mlab-upenn/Remote-Autonomous-Vehicle-Explorer-Network/images/photos/PartsArrivedNov1/CHRimu.JPG

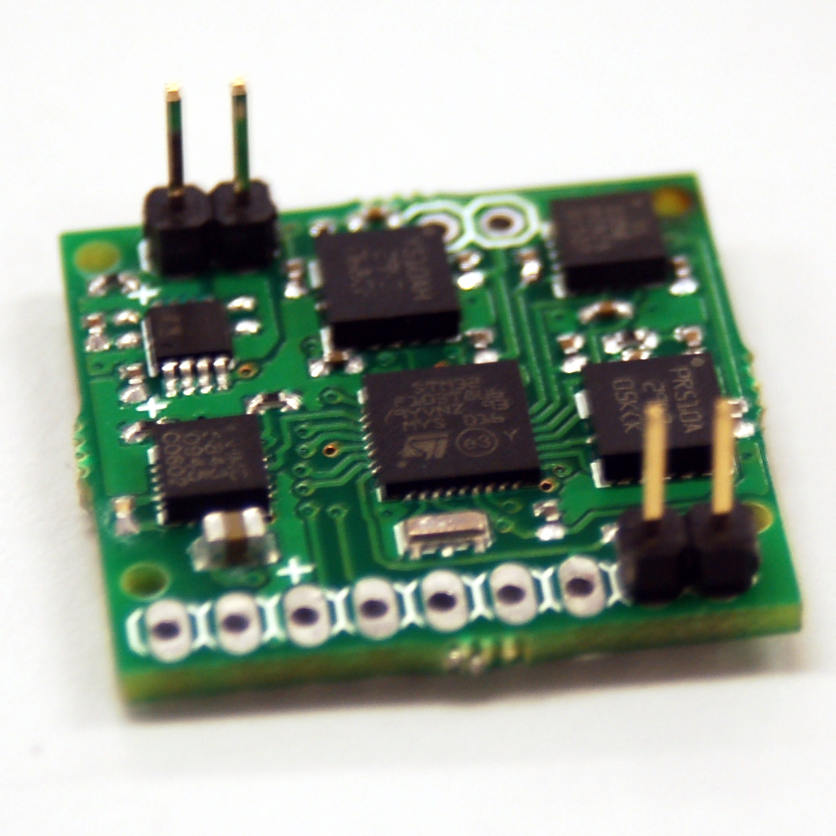
images/photos/PartsArrivedNov1/CHRimu.JPG
