mlab-upenn/Remote-Autonomous-Vehicle-Explorer-Network/images/photos/PartsArrivedNov1/exceedReceiver.JPG

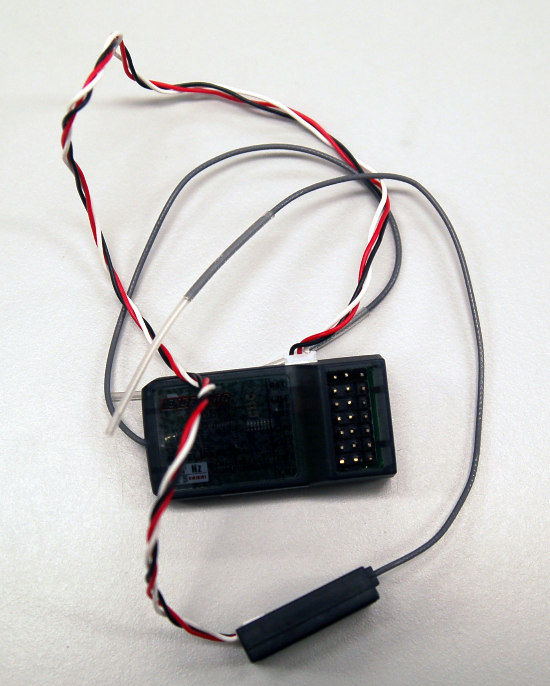
images/photos/PartsArrivedNov1/exceedReceiver.JPG
