mlab-upenn/Remote-Autonomous-Vehicle-Explorer-Network/codebase/ESC Firmware/17a410_ppm_r06/fuses_17a.jpg

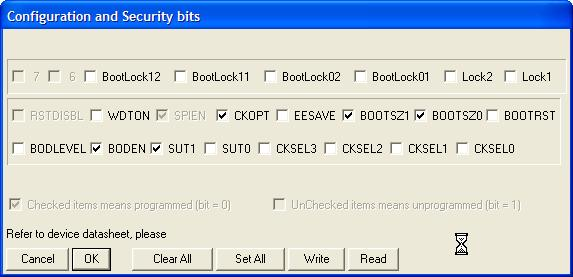
codebase/ESC Firmware/17a410_ppm_r06/fuses_17a.jpg
