mlab-upenn/Remote-Autonomous-Vehicle-Explorer-Network/codebase/ESC Firmware/TGYP2010_416HzRCIntervalRate_PPM-Mod-only_NoCal/CoRRECT FUSE SETTINGS.png

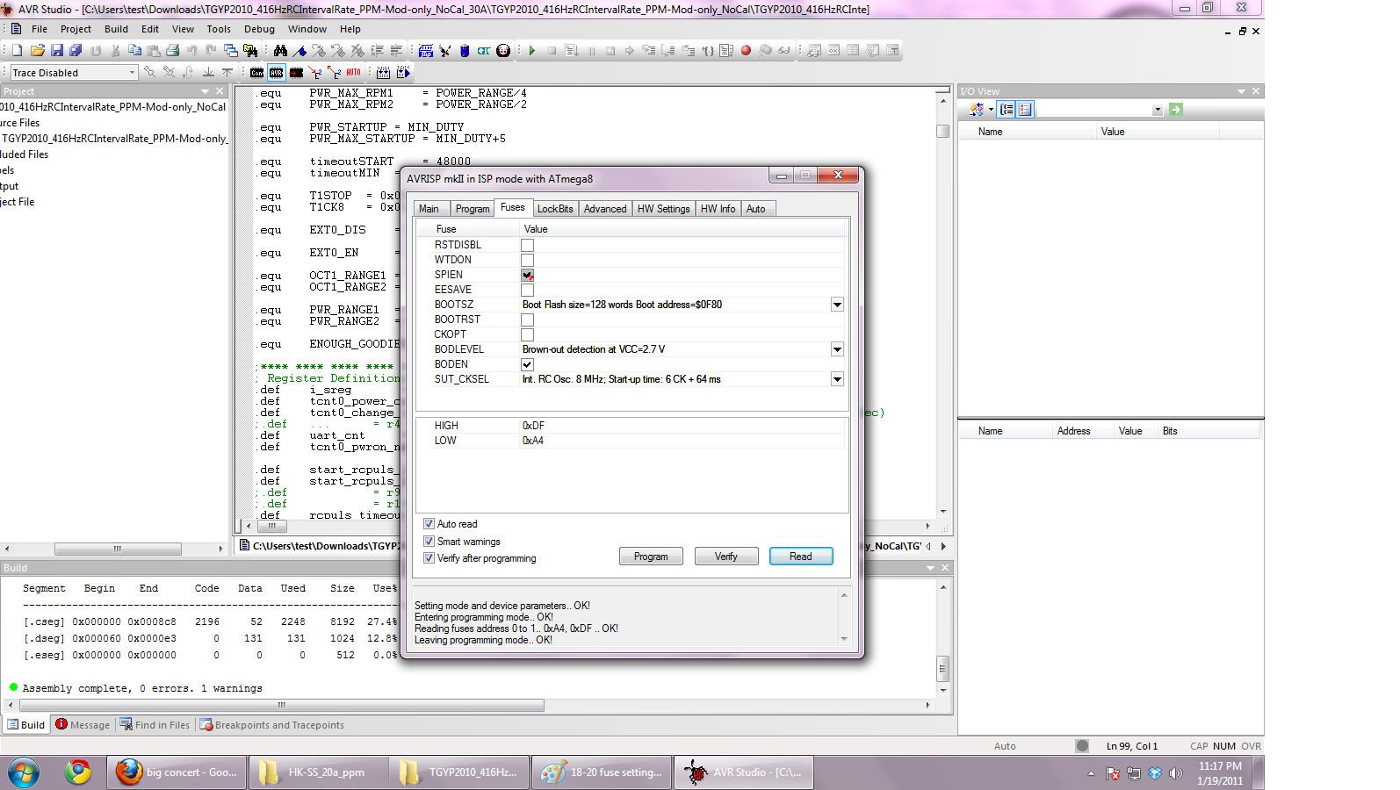
codebase/ESC Firmware/TGYP2010_416HzRCIntervalRate_PPM-Mod-only_NoCal/CoRRECT FUSE SETTINGS.png
