mlab-upenn/Remote-Autonomous-Vehicle-Explorer-Network/codebase/ESC Firmware/Working with HK SS 25-30A CP/Fuse Settings.png

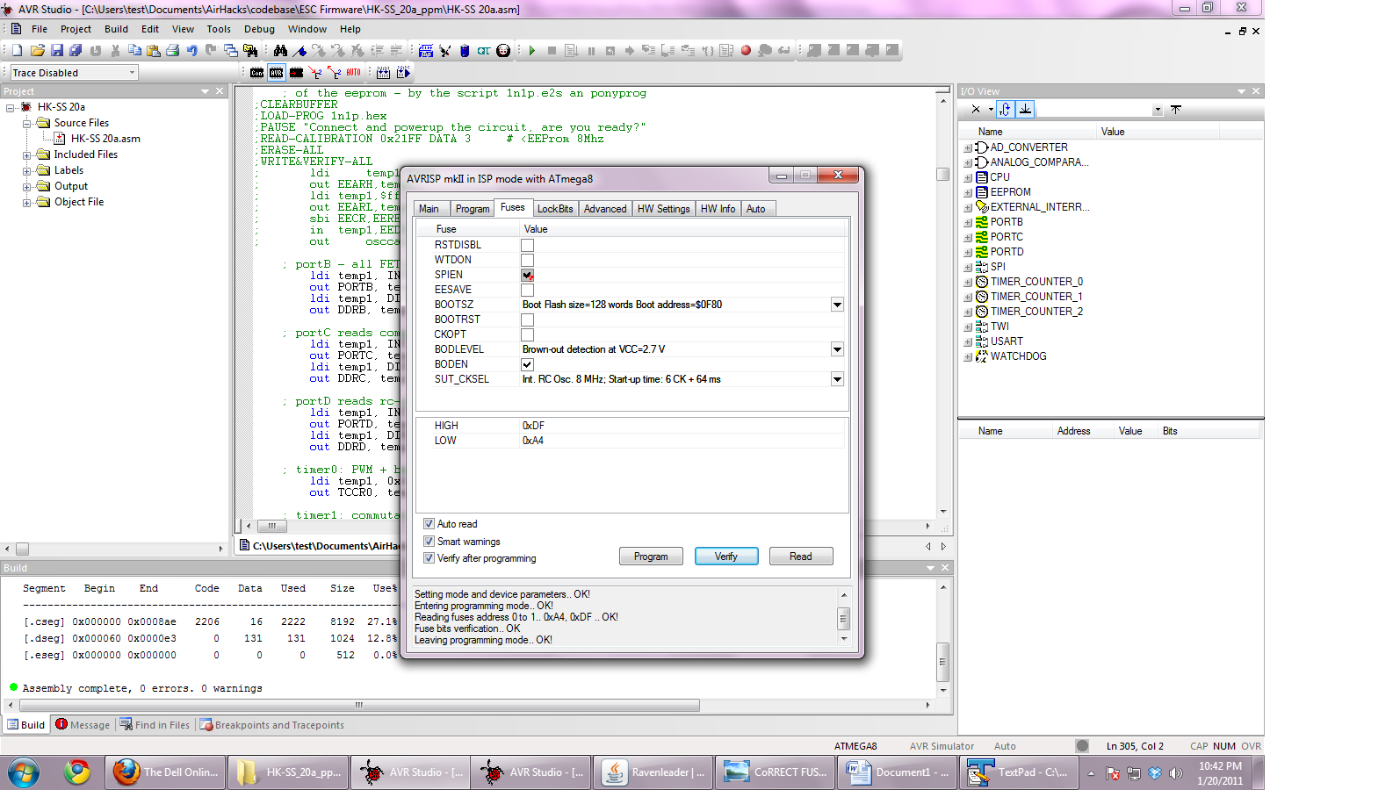
codebase/ESC Firmware/Working with HK SS 25-30A CP/Fuse Settings.png
