mlab-upenn/Remote-Autonomous-Vehicle-Explorer-Network/images/graphics/guiStart.png

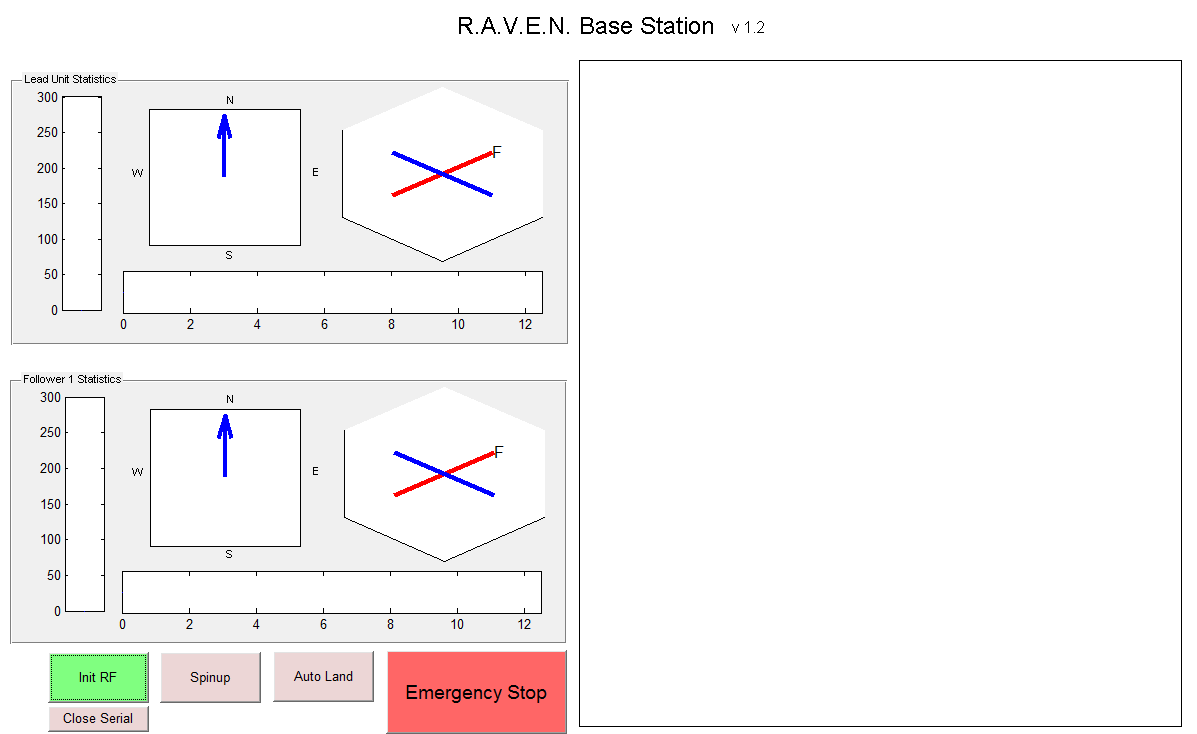
images/graphics/guiStart.png
