mlab-upenn/Remote-Autonomous-Vehicle-Explorer-Network/images/graphics/modelCamera.jpg

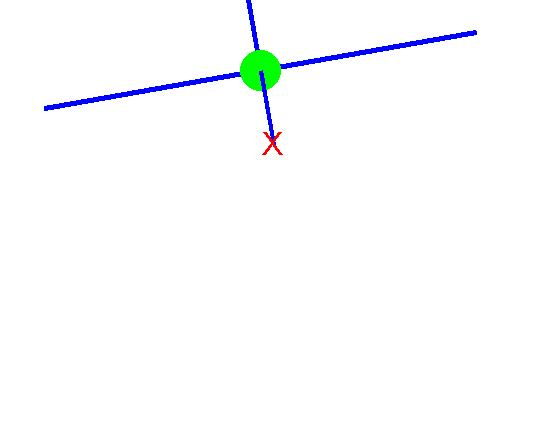
images/graphics/modelCamera.jpg
