mlab-upenn/Remote-Autonomous-Vehicle-Explorer-Network/images/graphics/modelPerspective.jpg

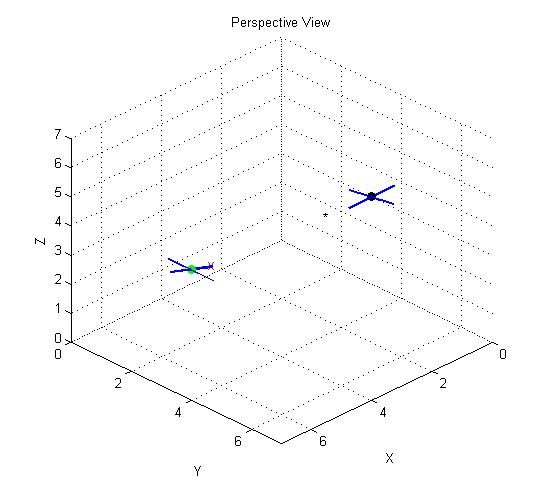
images/graphics/modelPerspective.jpg
