mlab-upenn/Remote-Autonomous-Vehicle-Explorer-Network/images/graphics/thrust1045.png

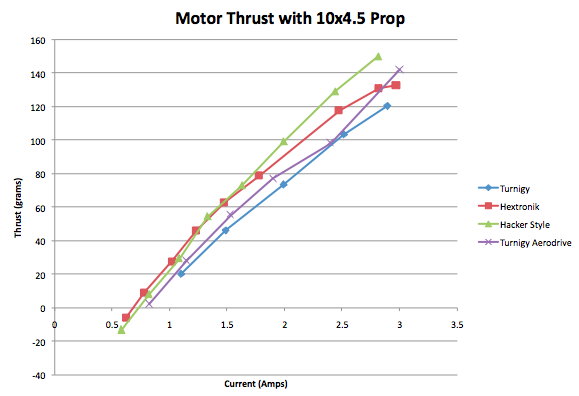
images/graphics/thrust1045.png
