mlab-upenn/Remote-Autonomous-Vehicle-Explorer-Network/images/photos/ESC/fuses.PNG

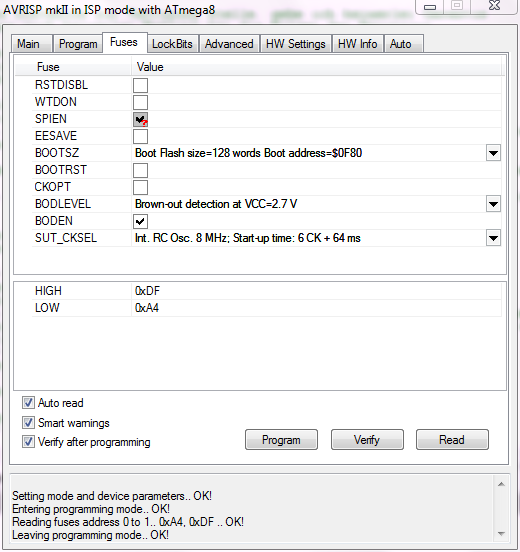
images/photos/ESC/fuses.PNG
