mlab-upenn/Remote-Autonomous-Vehicle-Explorer-Network/images/photos/GyroNoise/gyroNoiseFilter.png

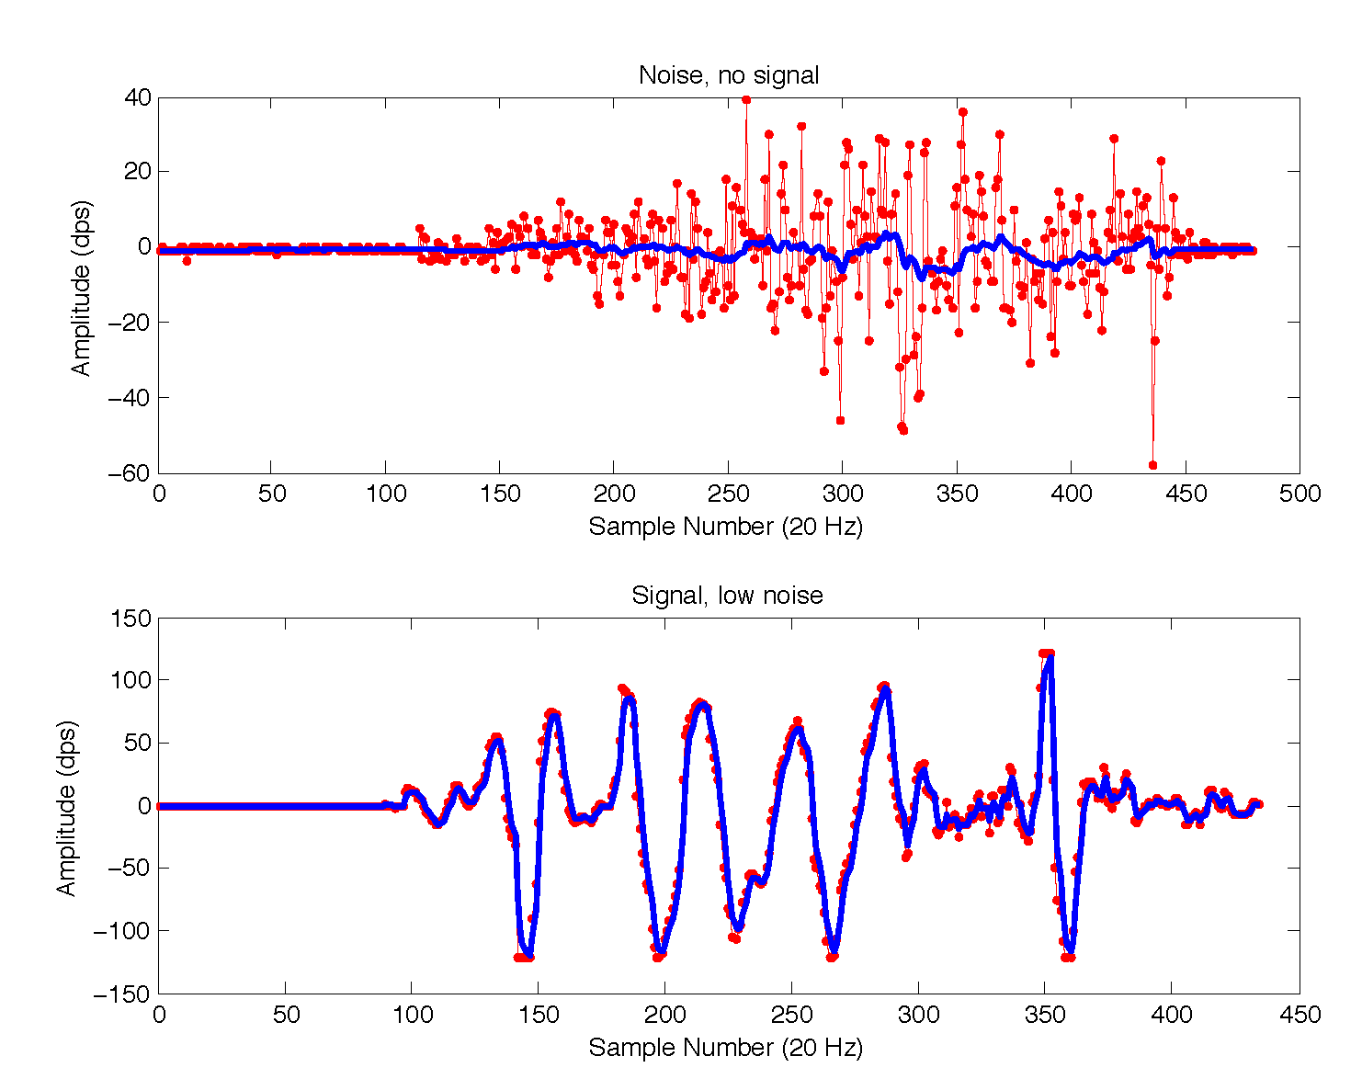
images/photos/GyroNoise/gyroNoiseFilter.png
