mlab-upenn/Remote-Autonomous-Vehicle-Explorer-Network/images/rateGyroScreenShots/angles props spinning/Screen shot 2011-03-27 at 12.30.48 AM.png

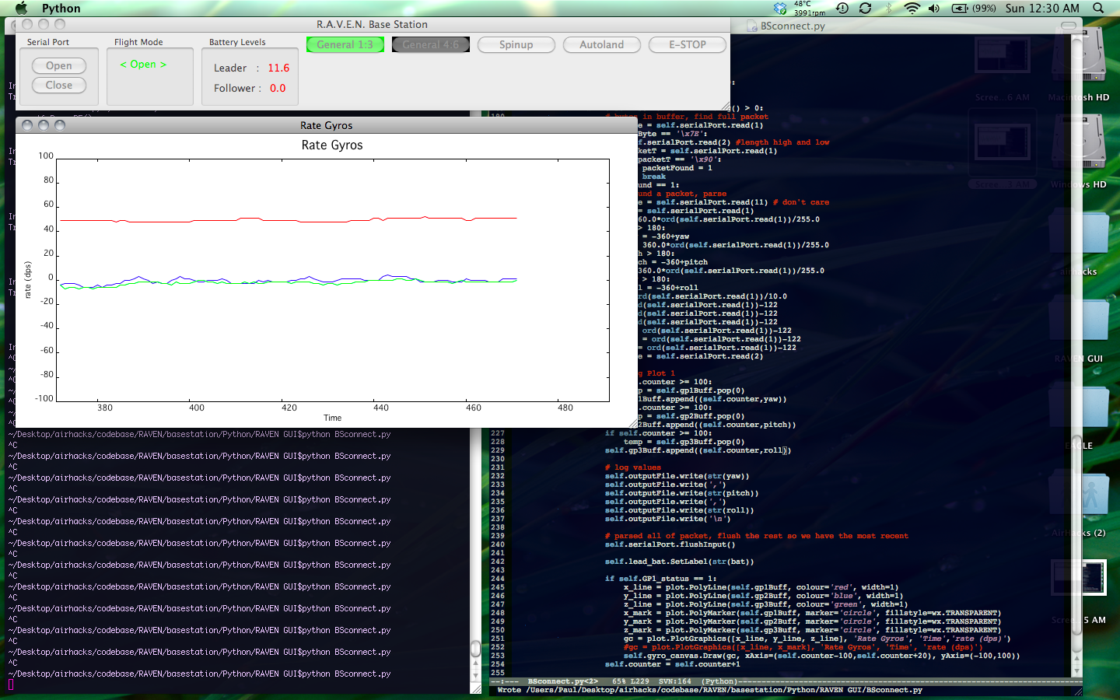
images/rateGyroScreenShots/angles props spinning/Screen shot 2011-03-27 at 12.30.48 AM.png
