mlab-upenn/Remote-Autonomous-Vehicle-Explorer-Network/images/rateGyroScreenShots/first round - light lambs wool and foam/Screen shot 2011-03-26 at 3.06.36 PM.png

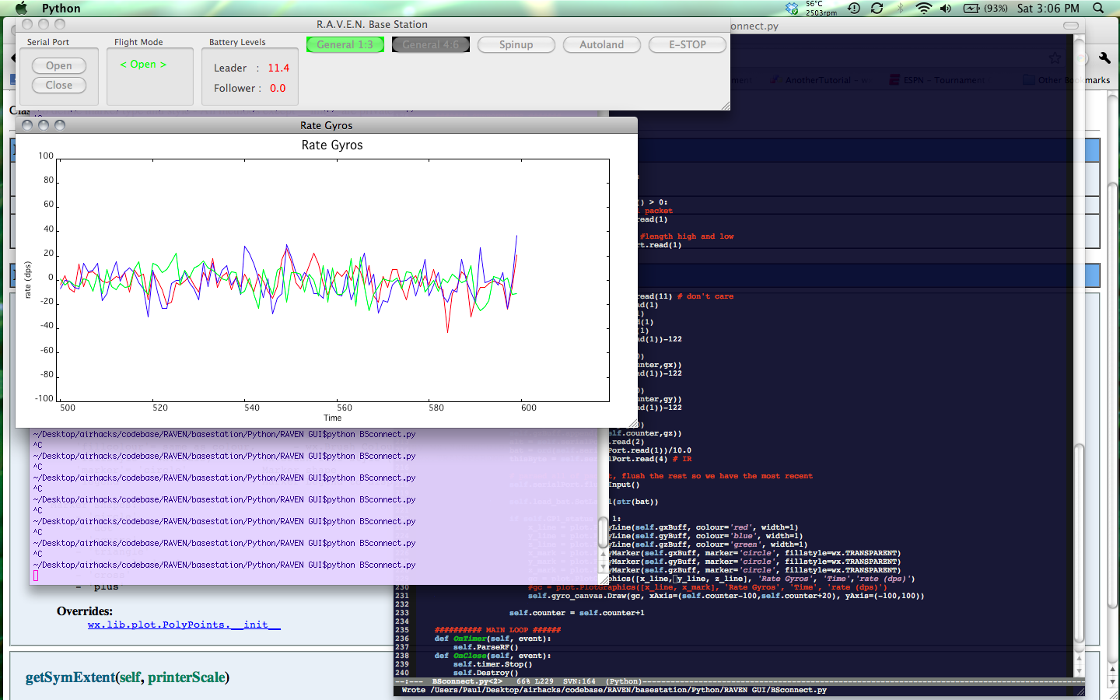
images/rateGyroScreenShots/first round - light lambs wool and foam/Screen shot 2011-03-26 at 3.06.36 PM.png
