mlab-upenn/Remote-Autonomous-Vehicle-Explorer-Network/images/rateGyroScreenShots/hardAttachedIMU/Screen shot 2011-03-26 at 11.12.29 PM.png

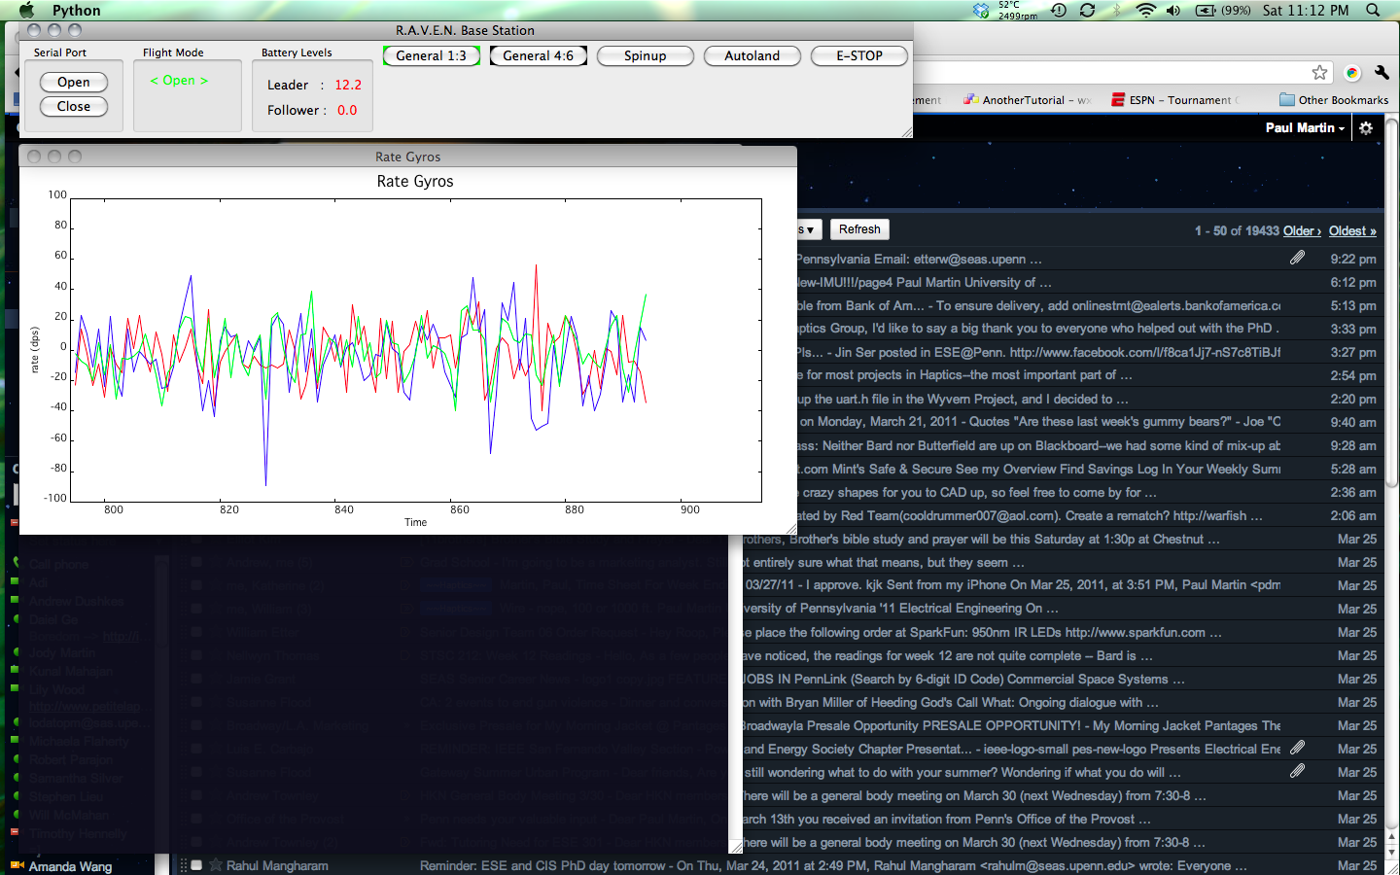
images/rateGyroScreenShots/hardAttachedIMU/Screen shot 2011-03-26 at 11.12.29 PM.png
