mlab-upenn/Remote-Autonomous-Vehicle-Explorer-Network/images/rateGyroScreenShots/in air/Screen shot 2011-03-26 at 3.31.38 PM.png

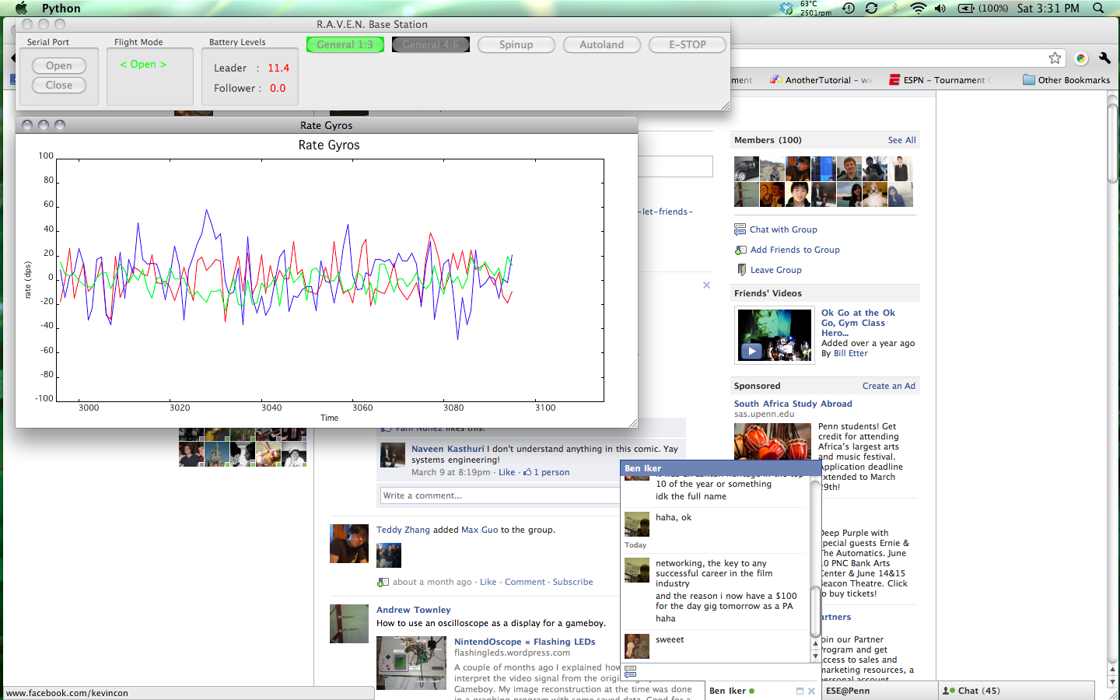
images/rateGyroScreenShots/in air/Screen shot 2011-03-26 at 3.31.38 PM.png
