mlab-upenn/Remote-Autonomous-Vehicle-Explorer-Network/images/rateGyroScreenShots/second round-only foam/Screen shot 2011-03-26 at 3.20.28 PM.png

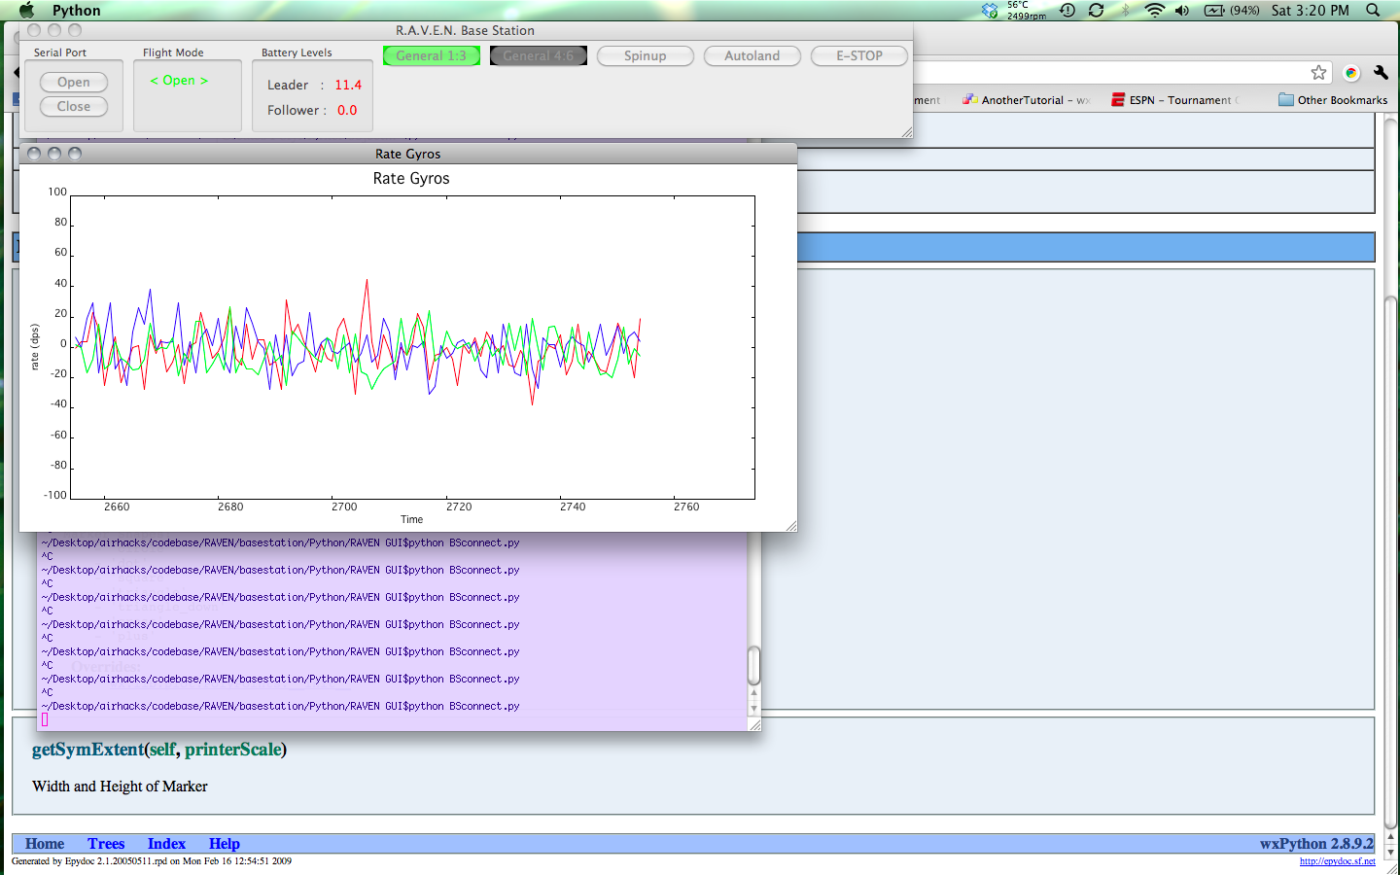
images/rateGyroScreenShots/second round-only foam/Screen shot 2011-03-26 at 3.20.28 PM.png
