mlab-upenn/Remote-Autonomous-Vehicle-Explorer-Network/images/rateGyroScreenShots/try2 only lambs wool/Screen shot 2011-03-26 at 3.26.39 PM.png

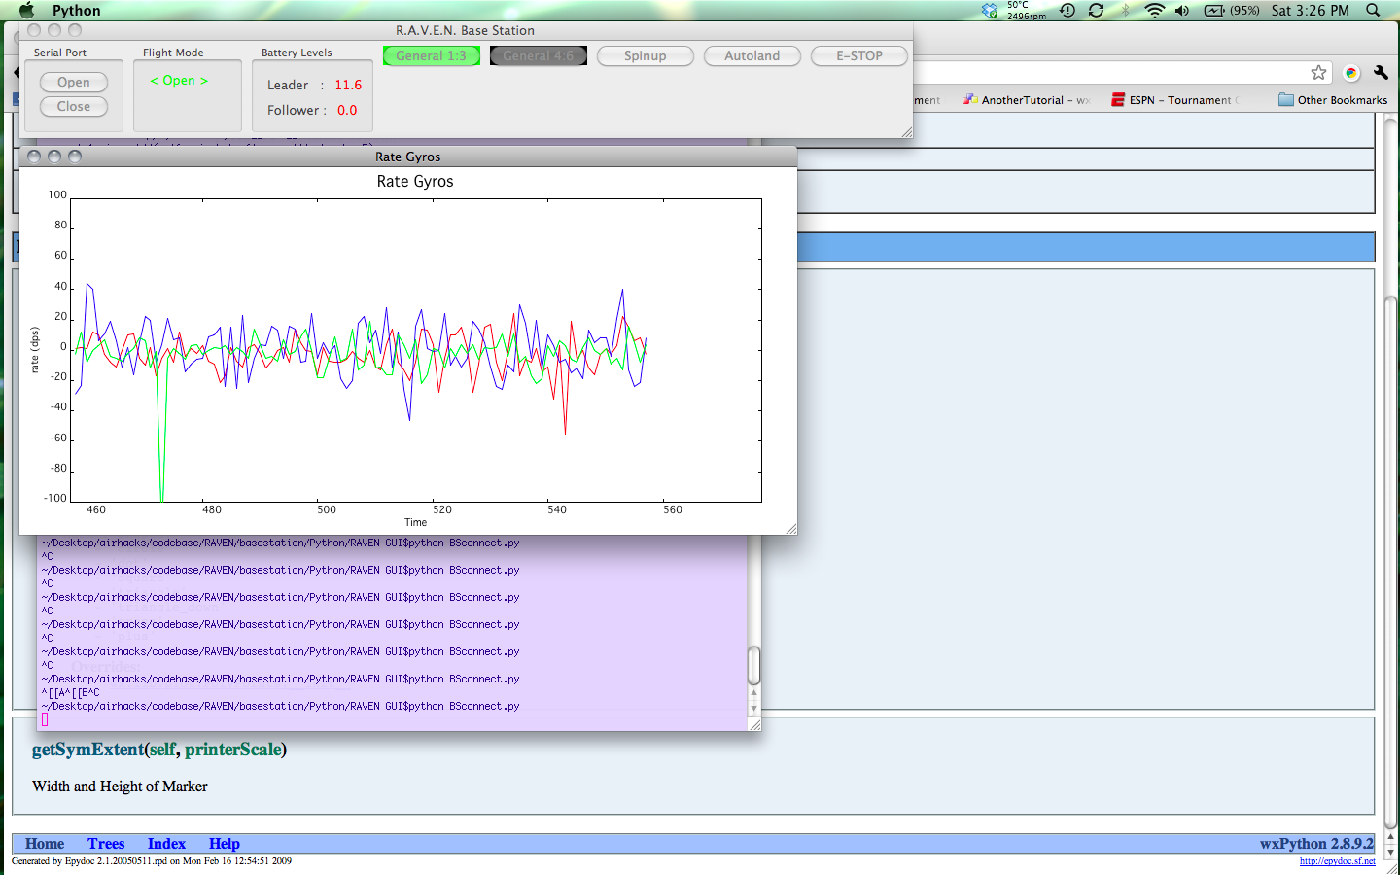
images/rateGyroScreenShots/try2 only lambs wool/Screen shot 2011-03-26 at 3.26.39 PM.png
