mlab-upenn/Remote-Autonomous-Vehicle-Explorer-Network/models/matlab/figures/deltaXpid.png

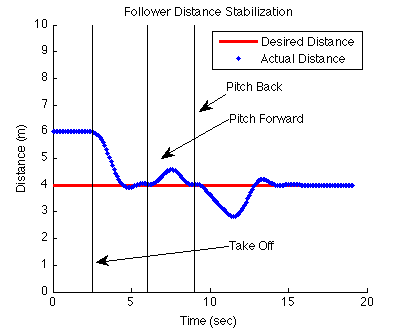
models/matlab/figures/deltaXpid.png
