mlab-upenn/Remote-Autonomous-Vehicle-Explorer-Network/models/matlab/figures/pitchPID.png

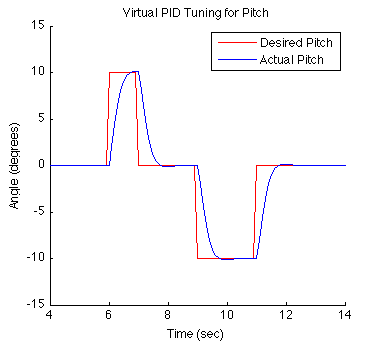
models/matlab/figures/pitchPID.png
