mlab-upenn/Remote-Autonomous-Vehicle-Explorer-Network/images/photos/PartsArrivedNov1/APM.JPG

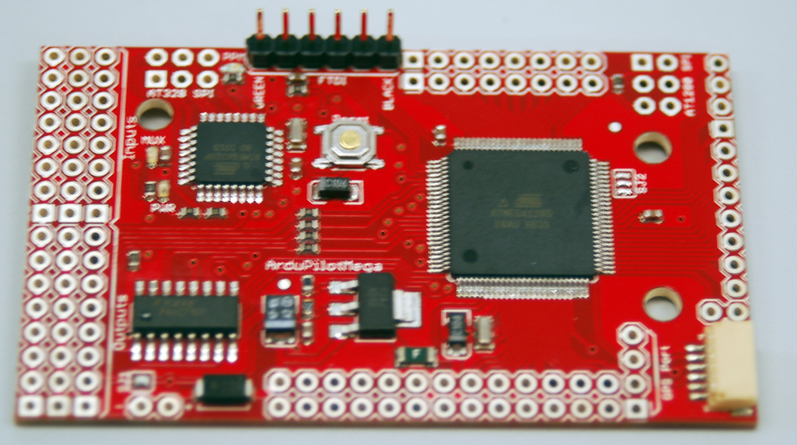
images/photos/PartsArrivedNov1/APM.JPG
