mlab-upenn/Remote-Autonomous-Vehicle-Explorer-Network/images/photos/PartsArrivedNov1/exceedRC.JPG

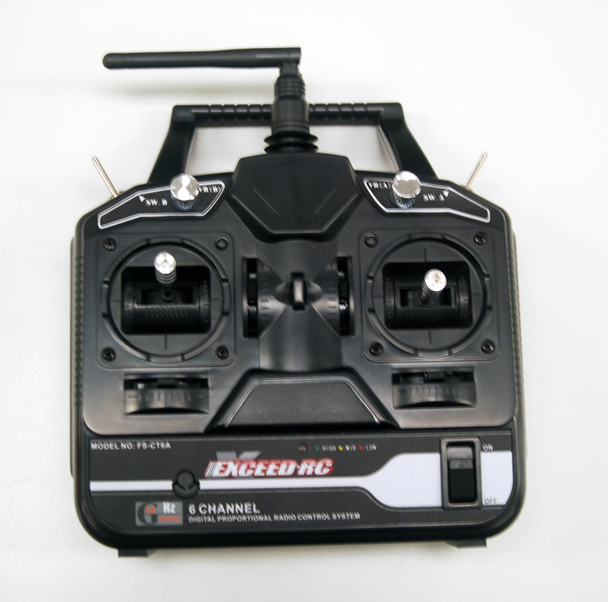
images/photos/PartsArrivedNov1/exceedRC.JPG
