mlab-upenn/Remote-Autonomous-Vehicle-Explorer-Network/images/photos/PartsArrivedNov1/frame.JPG

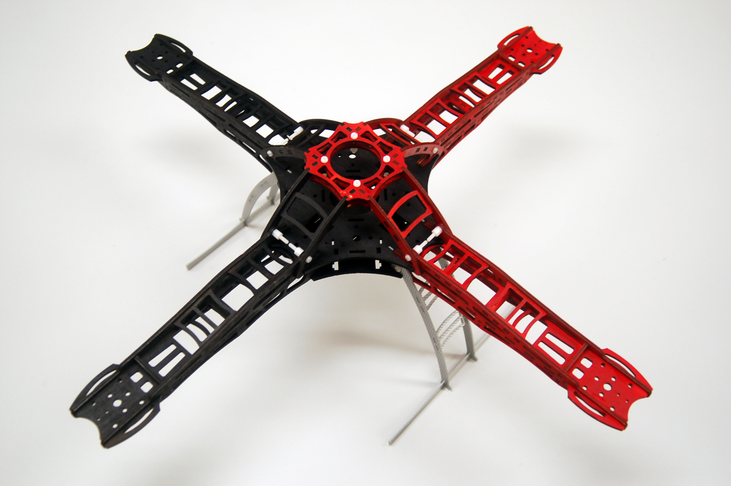
images/photos/PartsArrivedNov1/frame.JPG
