mlab-upenn/Remote-Autonomous-Vehicle-Explorer-Network/images/photos/PartsArrivedNov1/xbeeDuck.JPG

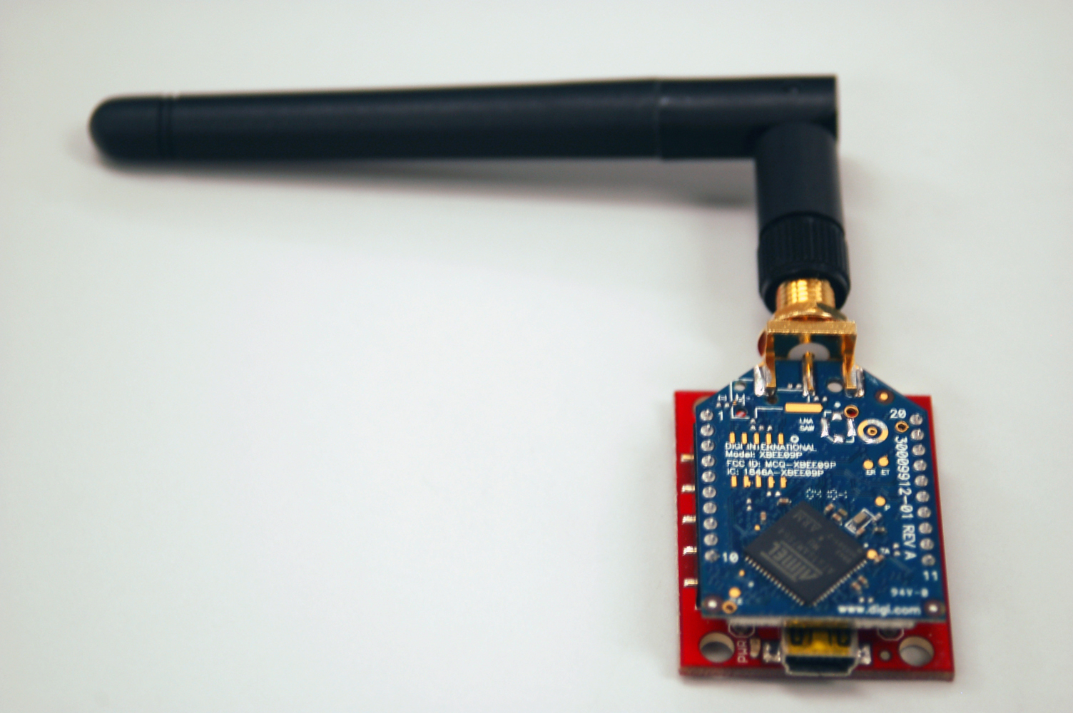
images/photos/PartsArrivedNov1/xbeeDuck.JPG
