mlab-upenn/Remote-Autonomous-Vehicle-Explorer-Network/images/photos/PartsArrivedNov1/xbeeWire.JPG

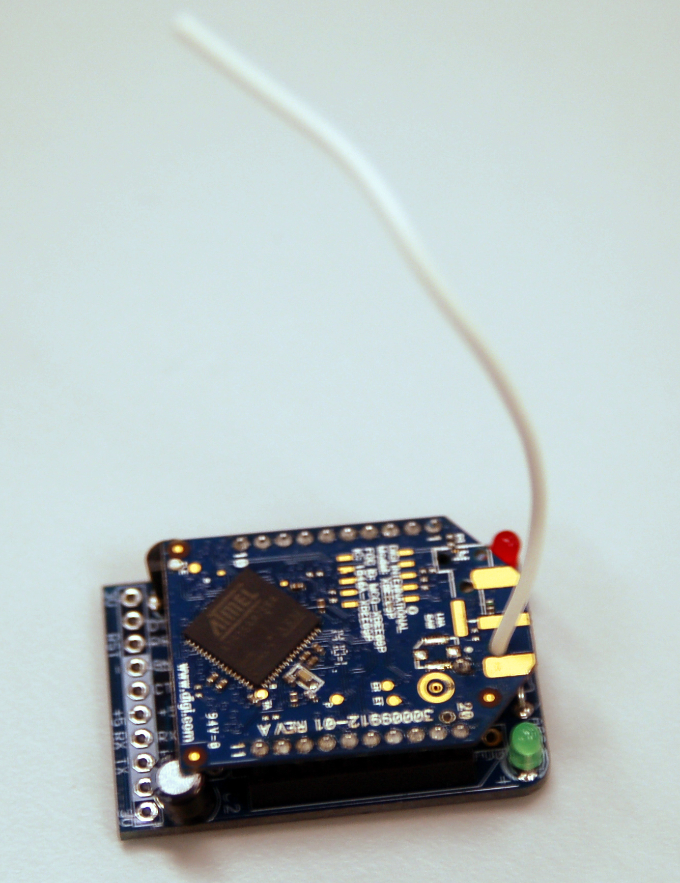
images/photos/PartsArrivedNov1/xbeeWire.JPG
