mlab-upenn/Remote-Autonomous-Vehicle-Explorer-Network/models/solidworks/Wyvern/Wyvern/FullAssembly.SLDASM

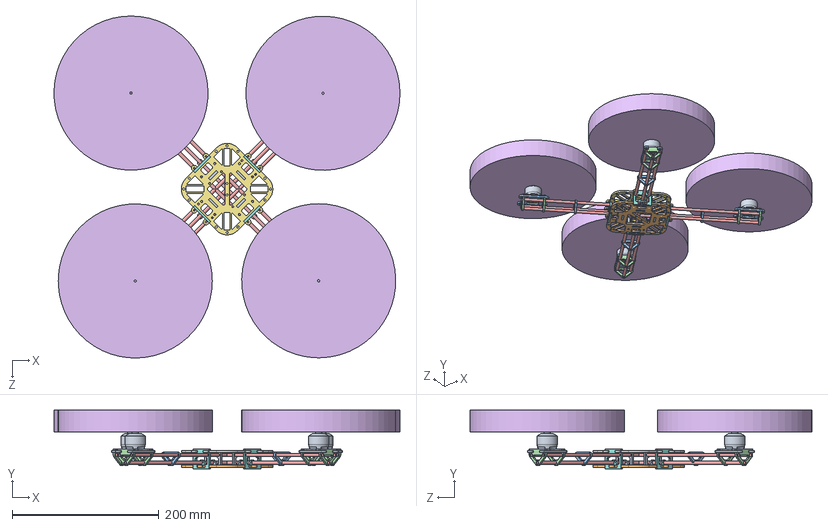
[picture p61: CAD file, 2012-02-28]
models/solidworks/Wyvern/Wyvern/FullAssembly.SLDASM
471.6 x 80.3 x 466.0 mm
a2208-14 x 4
MotorMount x 4
MotorNodeBase x 4
MotorNodeSide x 8
aluminumRod x 6
rotorest x 4
CenterNodeBaseTop
CenterNodeSide x 4
CenterNodeSideInner x 4
CenterNodeBaseBottom
SupportSide x 4
