mlab-upenn/Remote-Autonomous-Vehicle-Explorer-Network/models/solidworks/Wyvern/Wyvern/Motor/MotorAssem.SLDASM

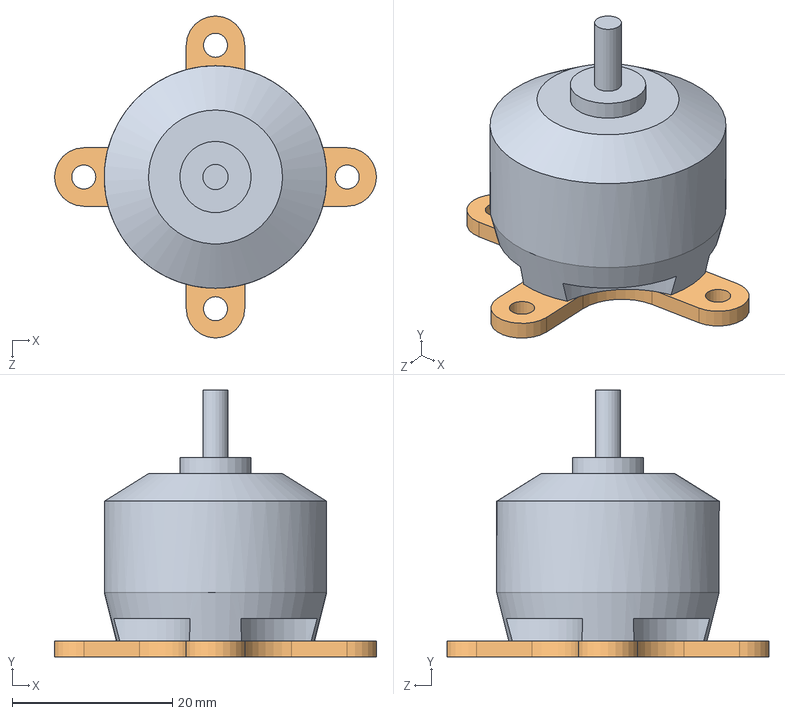
[picture p62: CAD file, 2012-02-28]
models/solidworks/Wyvern/Wyvern/Motor/MotorAssem.SLDASM
40.2 x 33.2 x 40.1 mm
a2208-14
MotorMount
