mlab-upenn/Remote-Autonomous-Vehicle-Explorer-Network/models/solidworks/Wyvern/Wyvern/MotorNode/MotorNodeAssem.SLDASM

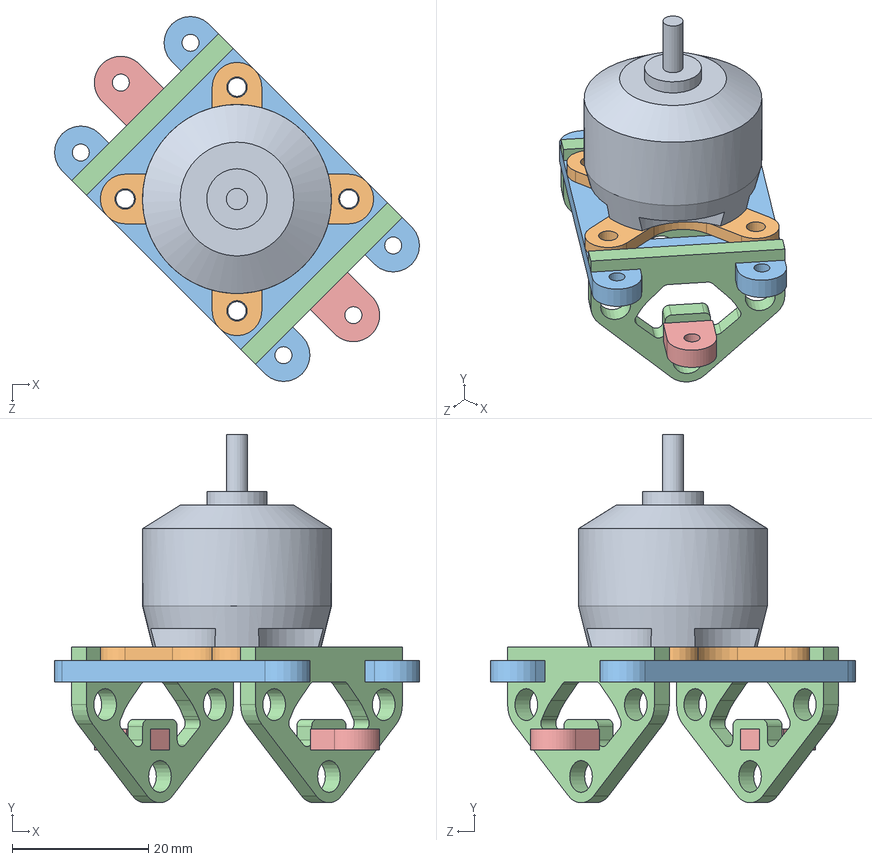
[picture p63: CAD file, 2012-02-28]
models/solidworks/Wyvern/Wyvern/MotorNode/MotorNodeAssem.SLDASM
53.6 x 54.1 x 53.6 mm
a2208-14
MotorMount
MotorNodeBase
MotorNodeSide x 2
ScrewNub x 2
