mlab-upenn/Remote-Autonomous-Vehicle-Explorer-Network/models/solidworks/Wyvern/Wyvern/NodeAssem.SLDASM

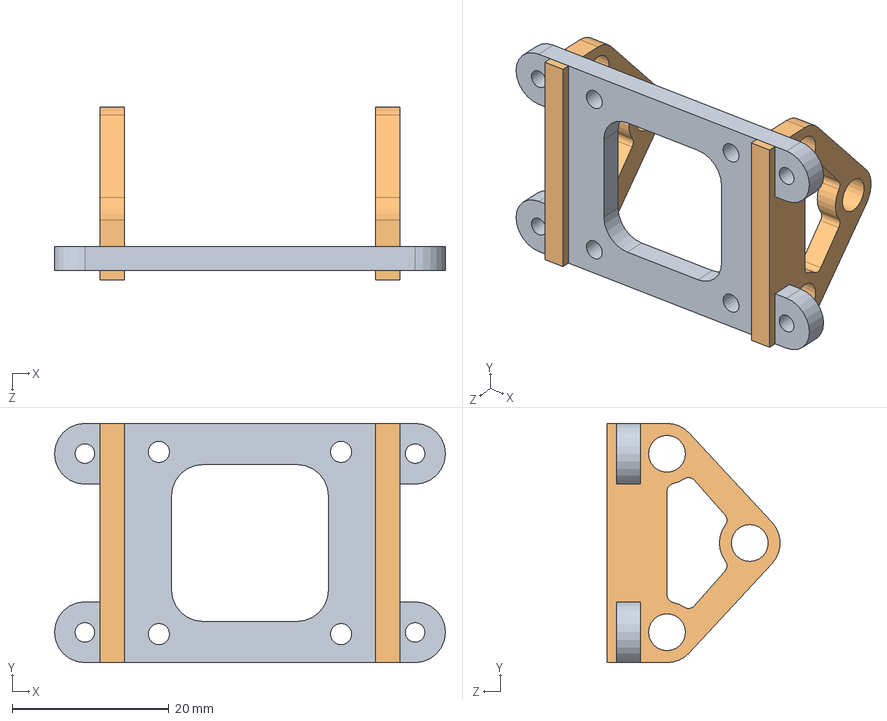
[picture p64: CAD file, 2012-02-28]
models/solidworks/Wyvern/Wyvern/NodeAssem.SLDASM
49.8 x 30.5 x 22.1 mm
MotorNodeBase
MotorNodeSide x 2
