mlab-upenn/Remote-Autonomous-Vehicle-Explorer-Network/models/solidworks/Wyvern/Wyvern/CenterNode/CenterNodeAssem.SLDASM

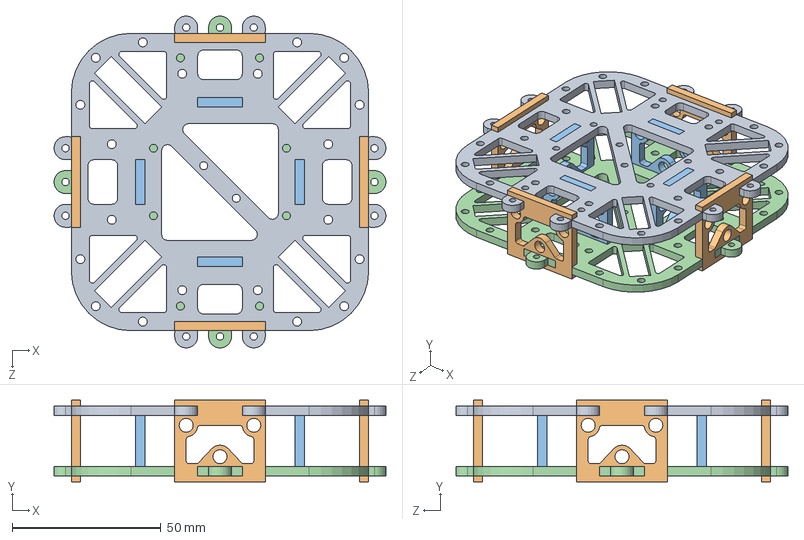
[picture p65: CAD file, 2012-02-28]
models/solidworks/Wyvern/Wyvern/CenterNode/CenterNodeAssem.SLDASM
111.7 x 27.5 x 111.7 mm
CenterNodeBaseTop
CenterNodeSide x 4
CenterNodeSideInner x 4
CenterNodeBaseBottom
