mlab-upenn/Remote-Autonomous-Vehicle-Explorer-Network/models/solidworks/Wyvern/Wyvern/HalfAssembly.SLDASM

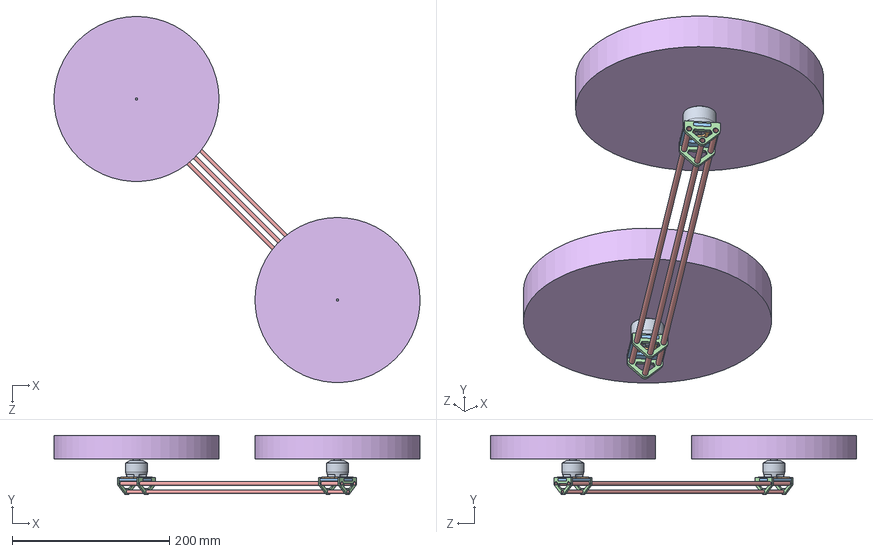
[picture p66: CAD file, 2012-02-28]
models/solidworks/Wyvern/Wyvern/HalfAssembly.SLDASM
465.7 x 75.7 x 465.8 mm
a2208-14 x 2
MotorMount x 2
MotorNodeBase x 2
MotorNodeSide x 4
aluminumRod x 3
rotorest x 2
