mlab-upenn/Remote-Autonomous-Vehicle-Explorer-Network/models/solidworks/Wyvern/Wyvern/Boards/Razor.SLDPRT

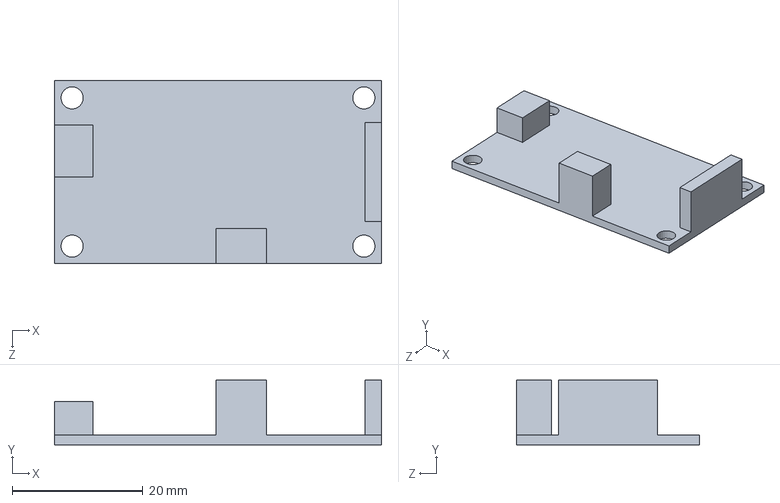
[picture p67: CAD file, 2012-02-28]
models/solidworks/Wyvern/Wyvern/Boards/Razor.SLDPRT
50.1 x 9.94 x 28.1 mm
