mlab-upenn/Remote-Autonomous-Vehicle-Explorer-Network/models/solidworks/Wyvern/Wyvern/CenterNode/CenterNodeBaseBottom.SLDPRT

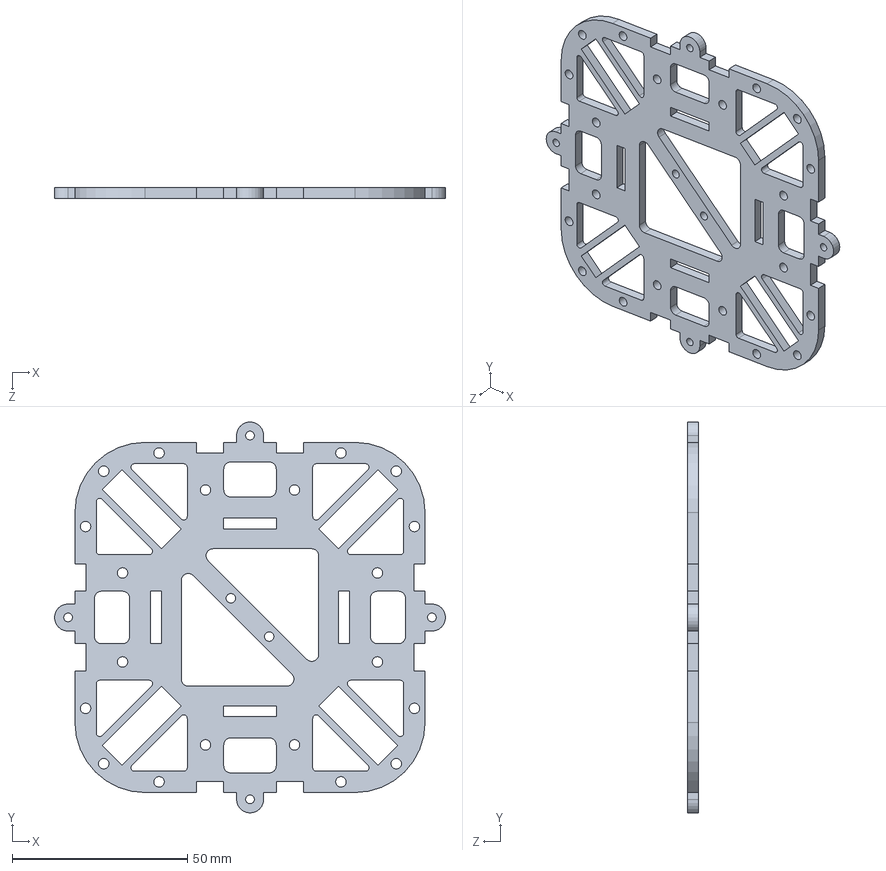
[picture p68: CAD file, 2012-02-28]
models/solidworks/Wyvern/Wyvern/CenterNode/CenterNodeBaseBottom.SLDPRT
111.7 x 111.6 x 3.10 mm
