mlab-upenn/Remote-Autonomous-Vehicle-Explorer-Network/models/solidworks/Wyvern/Wyvern/Motor/ESC.SLDPRT

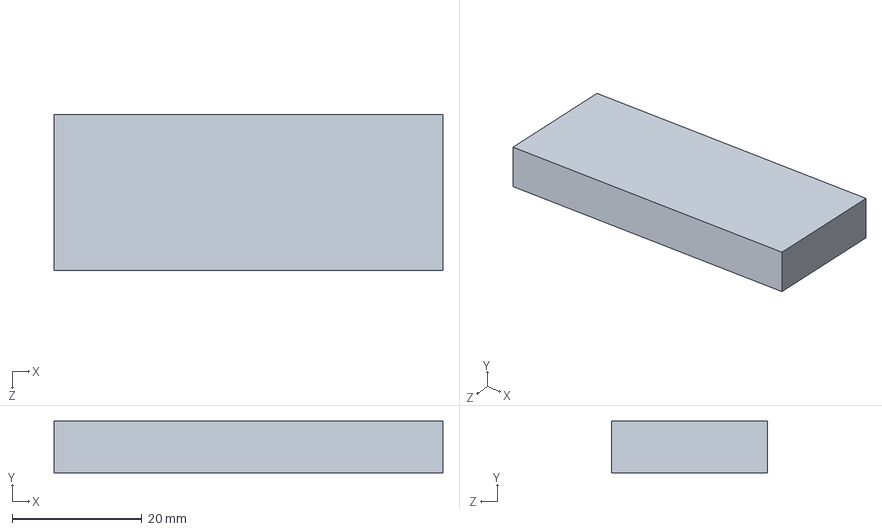
[picture p69: CAD file, 2012-02-28]
models/solidworks/Wyvern/Wyvern/Motor/ESC.SLDPRT
60.0 x 8.00 x 24.0 mm
