mlab-upenn/Remote-Autonomous-Vehicle-Explorer-Network/models/solidworks/Wyvern/Wyvern/MotorNode/MotorNodeBase.SLDPRT

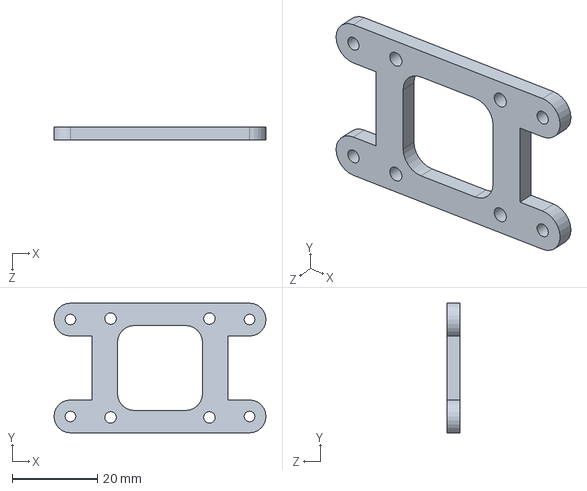
[picture p70: CAD file, 2012-02-28]
models/solidworks/Wyvern/Wyvern/MotorNode/MotorNodeBase.SLDPRT
49.8 x 30.5 x 3.10 mm
