mlab-upenn/Remote-Autonomous-Vehicle-Explorer-Network/models/solidworks/Wyvern/Wyvern/Boards/MAEVARM.SLDPRT

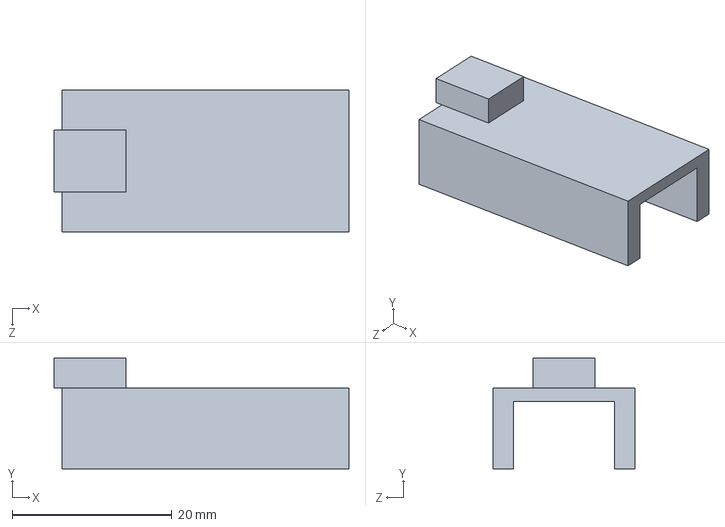
[picture p71: CAD file, 2012-02-28]
models/solidworks/Wyvern/Wyvern/Boards/MAEVARM.SLDPRT
36.9 x 13.8 x 17.8 mm
