mlab-upenn/Remote-Autonomous-Vehicle-Explorer-Network/models/solidworks/Wyvern/Wyvern/Motor/blueLipoBattery.SLDPRT

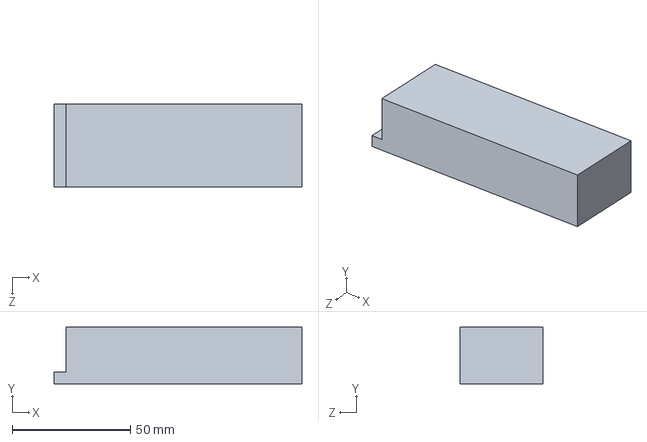
[picture p72: CAD file, 2012-02-28]
models/solidworks/Wyvern/Wyvern/Motor/blueLipoBattery.SLDPRT
105.0 x 24.0 x 35.0 mm
