mlab-upenn/Remote-Autonomous-Vehicle-Explorer-Network/models/solidworks/Wyvern/Wyvern/MotorNode/MotorNodeSide.SLDPRT

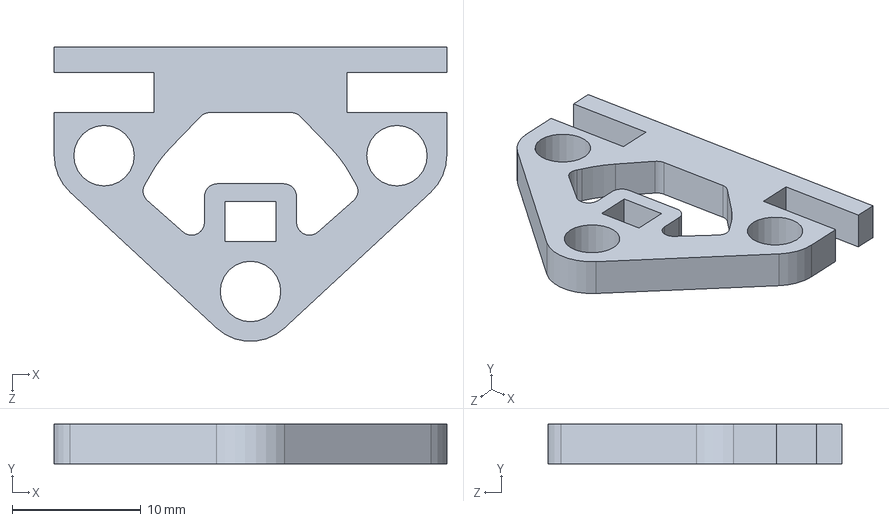
[picture p73: CAD file, 2012-02-28]
models/solidworks/Wyvern/Wyvern/MotorNode/MotorNodeSide.SLDPRT
30.5 x 3.10 x 22.9 mm
