mlab-upenn/Remote-Autonomous-Vehicle-Explorer-Network/models/solidworks/Wyvern/Wyvern/rotorest.SLDPRT

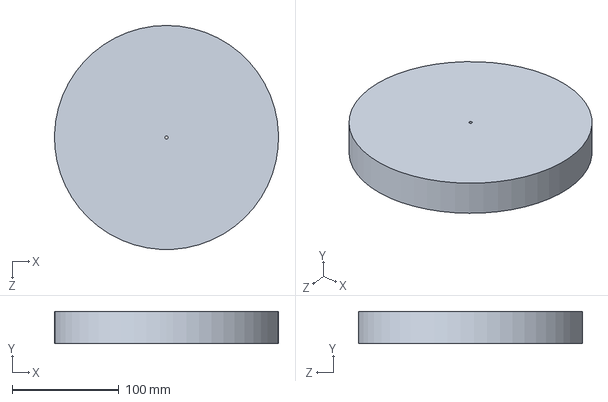
[picture p74: CAD file, 2012-02-28]
models/solidworks/Wyvern/Wyvern/rotorest.SLDPRT
209.9 x 30.0 x 210.0 mm
