mlab-upenn/Remote-Autonomous-Vehicle-Explorer-Network/models/solidworks/Wyvern/Wyvern/Boards/RF.SLDPRT

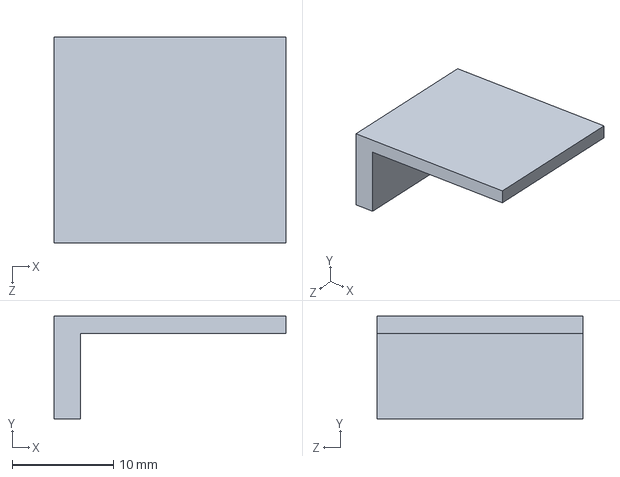
[picture p75: CAD file, 2012-02-28]
models/solidworks/Wyvern/Wyvern/Boards/RF.SLDPRT
22.9 x 10.1 x 20.3 mm
