mlab-upenn/Remote-Autonomous-Vehicle-Explorer-Network/models/solidworks/Wyvern/Wyvern/CenterNode/CenterNodeSideInner.SLDPRT

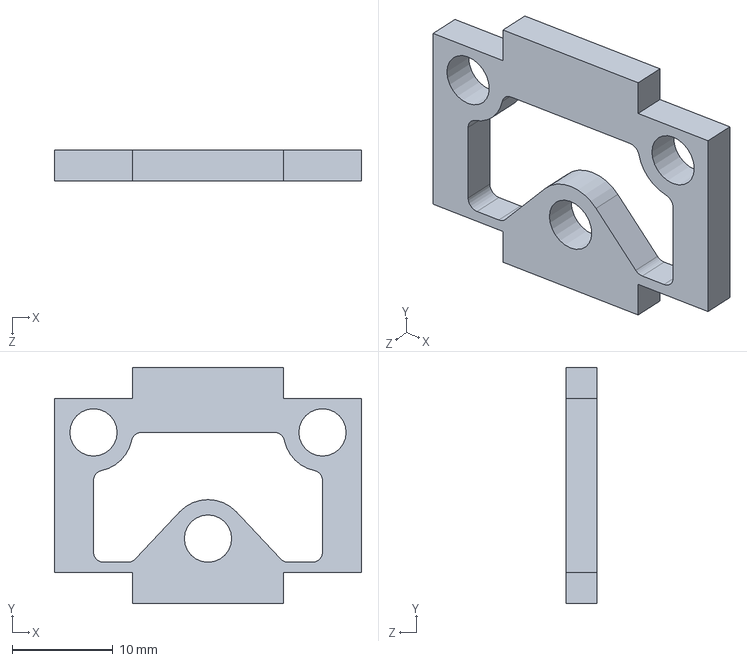
[picture p76: CAD file, 2012-02-28]
models/solidworks/Wyvern/Wyvern/CenterNode/CenterNodeSideInner.SLDPRT
30.5 x 23.4 x 3.10 mm
