mlab-upenn/Remote-Autonomous-Vehicle-Explorer-Network/models/solidworks/Wyvern/Wyvern/Boards/Barometer.SLDPRT

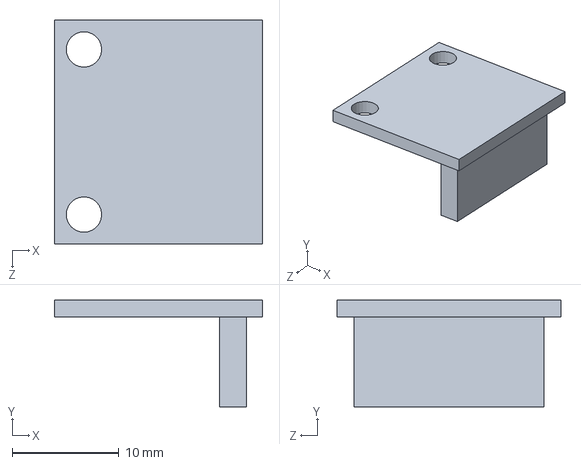
[picture p77: CAD file, 2012-02-28]
models/solidworks/Wyvern/Wyvern/Boards/Barometer.SLDPRT
19.5 x 10.0 x 21.0 mm
