mlab-upenn/Remote-Autonomous-Vehicle-Explorer-Network/models/solidworks/Wyvern/Wyvern/Motor/MotorMount.SLDPRT

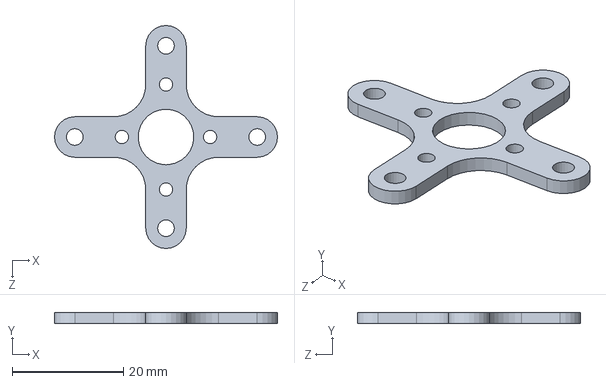
[picture p78: CAD file, 2012-02-28]
models/solidworks/Wyvern/Wyvern/Motor/MotorMount.SLDPRT
40.2 x 2.00 x 40.1 mm
