mlab-upenn/Remote-Autonomous-Vehicle-Explorer-Network/models/solidworks/Wyvern/Wyvern/CenterNode/CenterNodeSide.SLDPRT

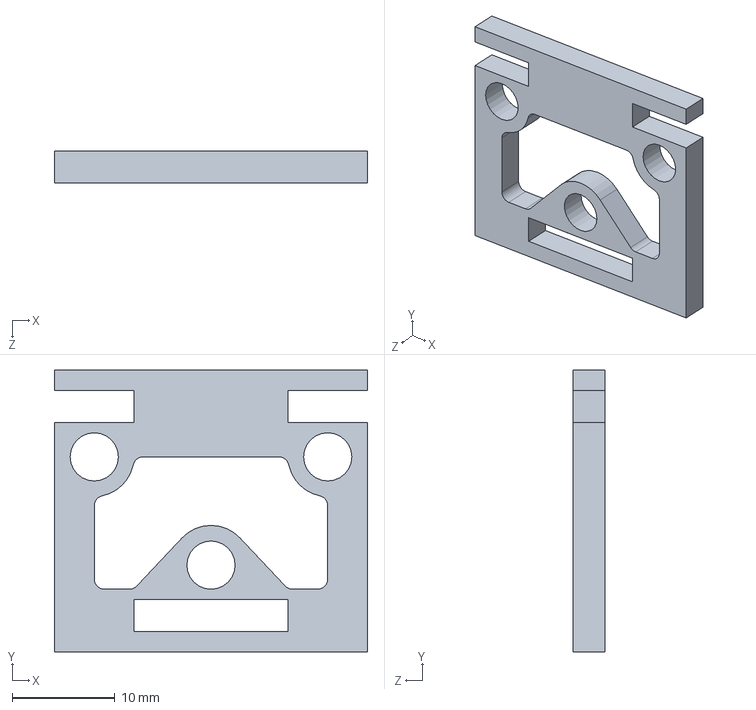
[picture p79: CAD file, 2012-02-28]
models/solidworks/Wyvern/Wyvern/CenterNode/CenterNodeSide.SLDPRT
30.5 x 27.5 x 3.10 mm
