mlab-upenn/Remote-Autonomous-Vehicle-Explorer-Network/models/solidworks/Wyvern/Wyvern/Motor/a2208-14.SLDPRT

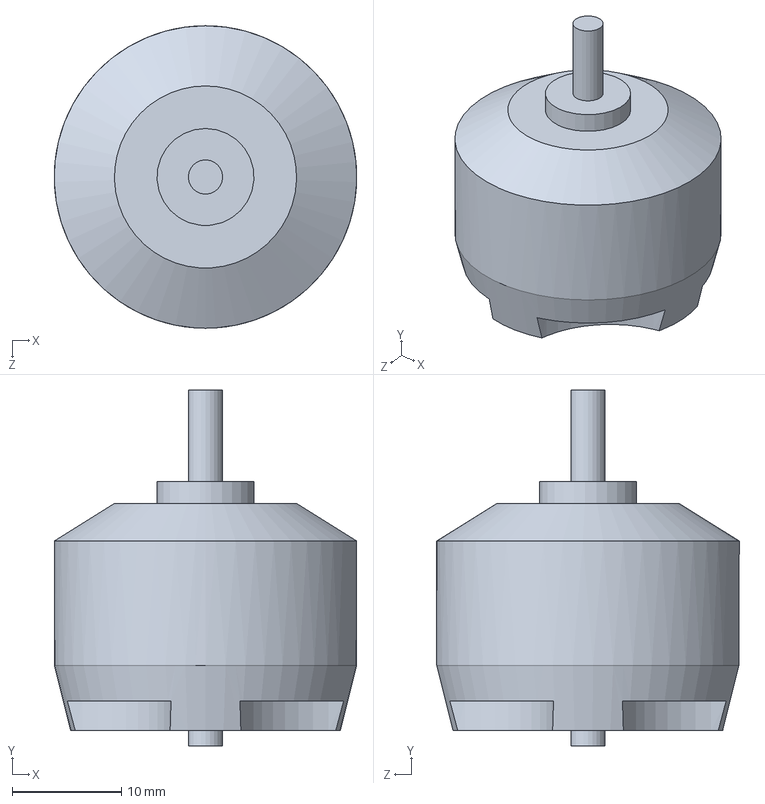
[picture p80: CAD file, 2012-02-28]
models/solidworks/Wyvern/Wyvern/Motor/a2208-14.SLDPRT
27.7 x 32.7 x 27.8 mm
