mlab-upenn/Remote-Autonomous-Vehicle-Explorer-Network/models/solidworks/Wyvern/Wyvern/SupportSide.SLDPRT

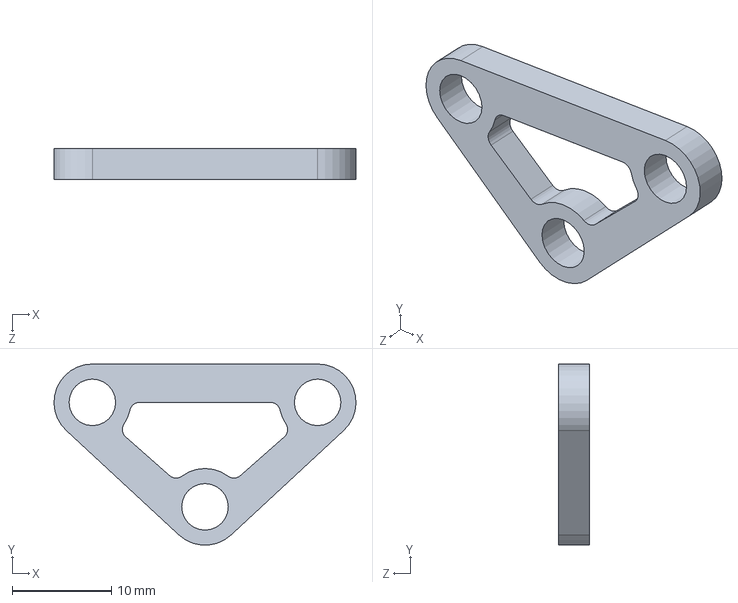
[picture p81: CAD file, 2012-02-28]
models/solidworks/Wyvern/Wyvern/SupportSide.SLDPRT
30.5 x 18.3 x 3.10 mm
