mlab-upenn/Remote-Autonomous-Vehicle-Explorer-Network/models/solidworks/Wyvern/Wyvern/aluminumRod.SLDPRT

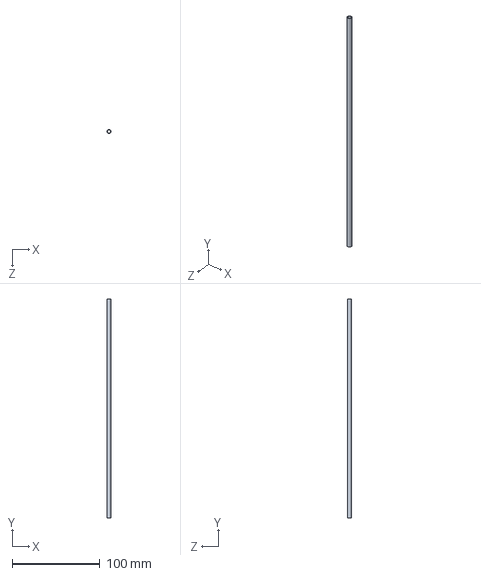
[picture p82: CAD file, 2012-02-28]
models/solidworks/Wyvern/Wyvern/aluminumRod.SLDPRT
4.70 x 250.0 x 4.70 mm
