mlab-upenn/Remote-Autonomous-Vehicle-Explorer-Network/(list of files, cad)

Other CAD files:
codebase/ESC Firmware/17a410_ppm_r06/bl-17a.obj
codebase/ESC Firmware/18a_tpro_ppm_r05/tp-18a.obj
codebase/ESC Firmware/HK-SS_20a_ppm/HK-SS 20a.obj
codebase/ESC Firmware/TGYP2010_416HzRCIntervalRate_PPM-Mod-only_NoCal/TGYP2010_416HzRCIntervalRate_PPM-Mod-only_NoCal.obj
models/solidworks/Wyvern/Wyvern/LaserModifications/MotorNodeSideModification.SLDPRT
models/solidworks/Wyvern/Wyvern/CenterNode/CenterNodeBaseTop.SLDPRT
models/solidworks/Wyvern/Wyvern/LaserModifications/MotorNodeSideModification.DWG
models/solidworks/Wyvern/Wyvern/LaserModifications/MotorNodeSideModification.SLDDRW
models/solidworks/Wyvern/Wyvern/MotorNode/ScrewNub.SLDPRT
