mlab-upenn/Remote-Autonomous-Vehicle-Explorer-Network/images/graphics/thrustSetup.pdf

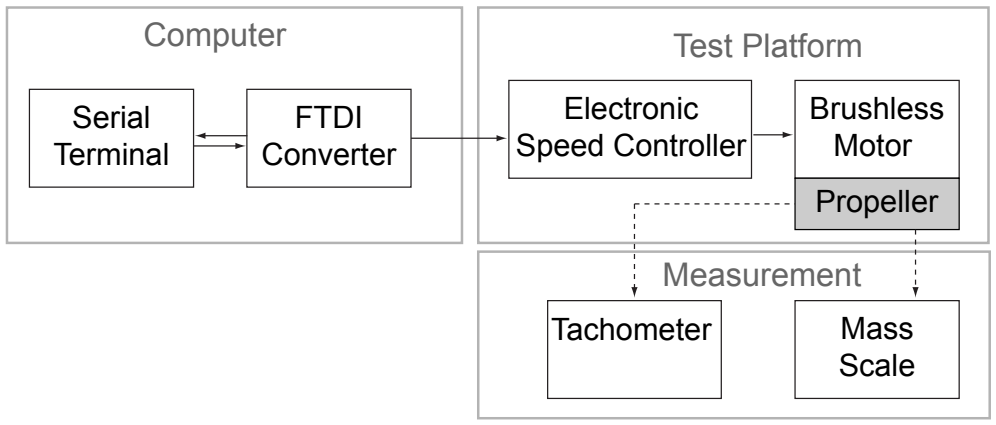
[picture p83: figure]
FTDI Converter; Computer; Serial Terminal; Test Platform; Brushless Motor; Electronic Speed Controller; Propeller; Mass Scale; Measurement Tachometer
