mlab-upenn/Remote-Autonomous-Vehicle-Explorer-Network/docs/RAVEN/MotorTests.xlsx

Sheet: 8038
Motor Thrust Tests
Prop: 8x3.8
Turnigy
Duty | Current (A) | RPM | Thrust (g) | Corrected Thrust | Net Thrust
600 | 0.97 | 3480 | 75 | 67 | 3.6
620 | 1.24 | 3780 | 93.4 | 85.4 | 22
640 | 1.57 | 4290 | 111.5 | 103.5 | 40.1
660 | 1.9 | 4650 | 130 | 122 | 58.6
680 | 2.27 | 4950 | 147 | 139 | 75.6
700 | 2.73 | 5280 | 167 | 159 | 95.6
710 | 2.92 | 5550 | 177 | 169 | 105.6
Hextronik
Duty | Current (A) | RPM | Thrust (g) | Corrected Thrust | Net Thrust
600 | 0.43 | 2490 | 74 | 37 | -2
620 | 0.57 | 2820 | 83.7 | 46.7 | 7.7
640 | 0.75 | 3180 | 94.2 | 57.2 | 18.2
660 | 0.94 | 3540 | 108 | 71 | 32
680 | 1.18 | 3810 | 123 | 86 | 47
700 | 1.4 | 4170 | 140 | 103 | 64
720 | 1.62 | 4380 | 149 | 112 | 73
740 | 1.91 | 4680 | 162 | 125 | 86
760 | 2.19 | 4980 | 181 | 144 | 105
780 | 2.5 | 5220 | 194 | 157 | 118
800 | 2.83 | 5430 | 214 | 177 | 138
810 | 2.97 | 5550 | 222 | 185 | 146
Hacker Style
Duty | Current (A) | RPM | Thrust (g) | Corrected Thrust | Net Thrust
600 | 0.43 | 2670 | 66 | 38 | -26.7
620 | 0.53 | 3000 | 77.3 | 49.3 | -15.4
640 | 0.64 | 3360 | 91 | 63 | -1.7
660 | 0.82 | 3660 | 103 | 75 | 10.3
680 | 1.05 | 3990 | 120 | 92 | 27.3
700 | 1.26 | 4230 | 136 | 108 | 43.3
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
