mlab-upenn/Remote-Autonomous-Vehicle-Explorer-Network/images/photos/ThrustTestOct29/beagleboard.JPG

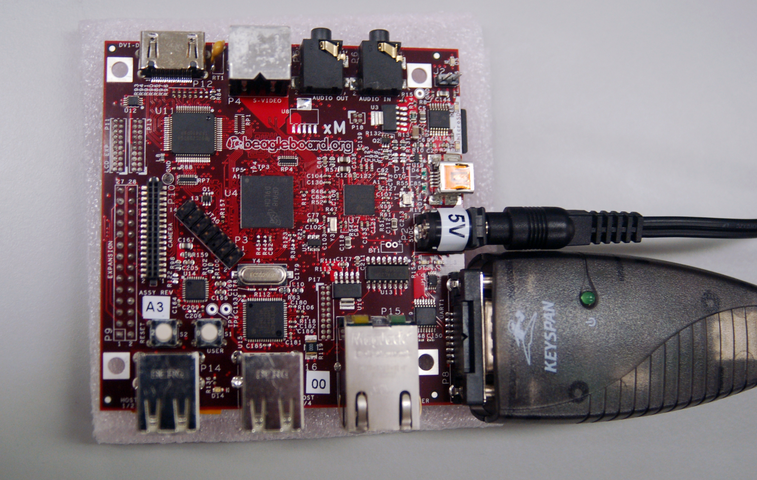
images/photos/ThrustTestOct29/beagleboard.JPG
