mlab-upenn/Remote-Autonomous-Vehicle-Explorer-Network/images/photos/ThrustTestOct29/framecenter.JPG

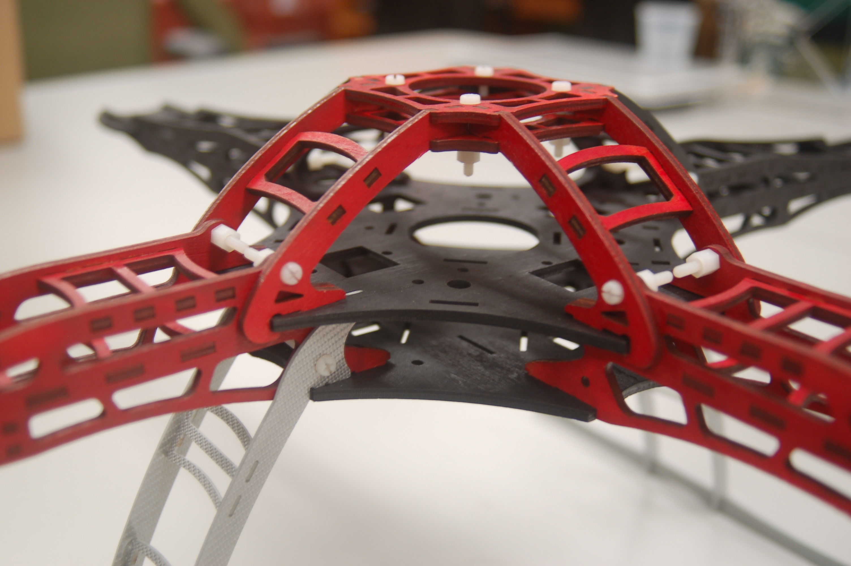
images/photos/ThrustTestOct29/framecenter.JPG
