mlab-upenn/Remote-Autonomous-Vehicle-Explorer-Network/images/photos/ThrustTestOct29/framecenteredited.jpg

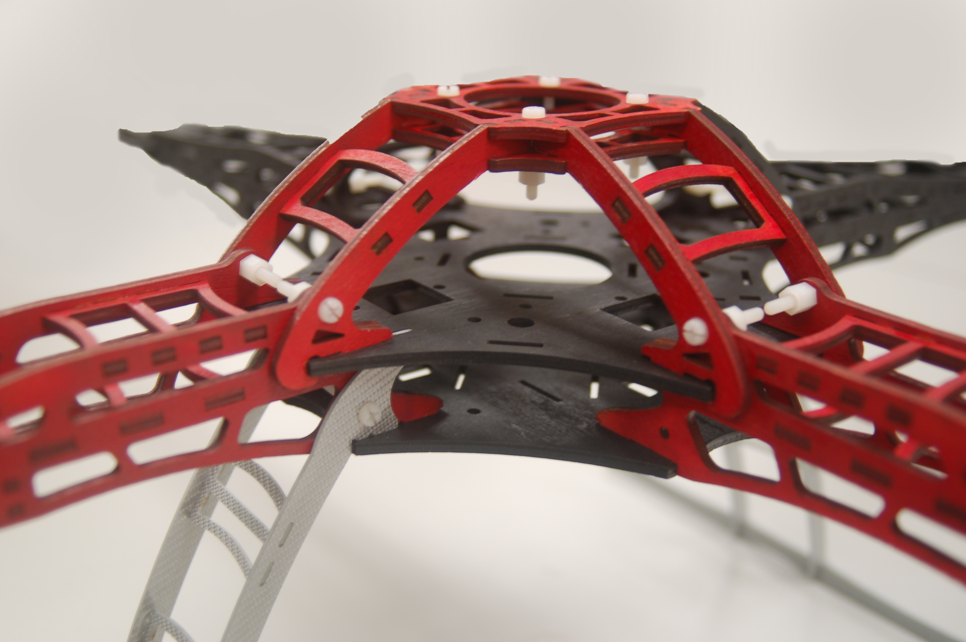
images/photos/ThrustTestOct29/framecenteredited.jpg
