mlab-upenn/Remote-Autonomous-Vehicle-Explorer-Network/images/photos/ThrustTestOct29/framewhole.JPG

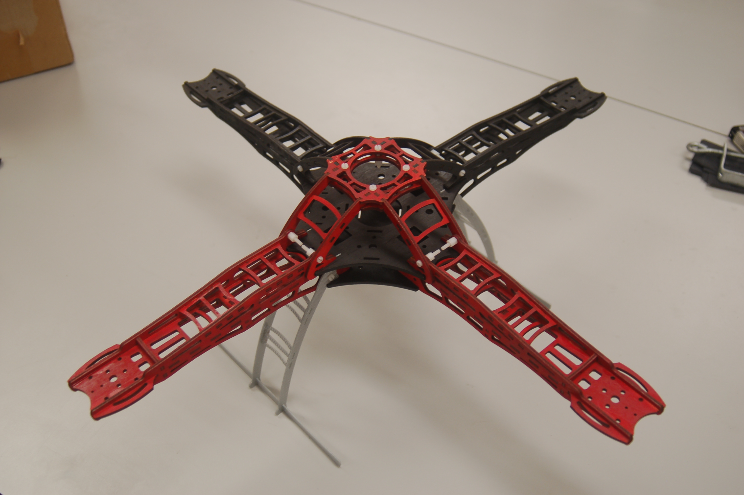
images/photos/ThrustTestOct29/framewhole.JPG
