mlab-upenn/Remote-Autonomous-Vehicle-Explorer-Network/images/photos/ThrustTestOct29/motors.JPG

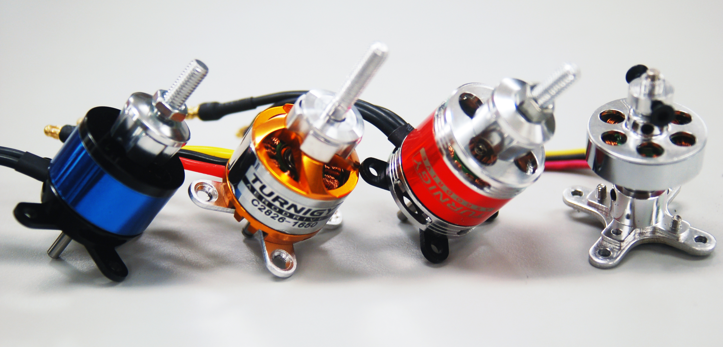
images/photos/ThrustTestOct29/motors.JPG
