mlab-upenn/Remote-Autonomous-Vehicle-Explorer-Network/images/photos/ThrustTestOct29/thrustTest.JPG

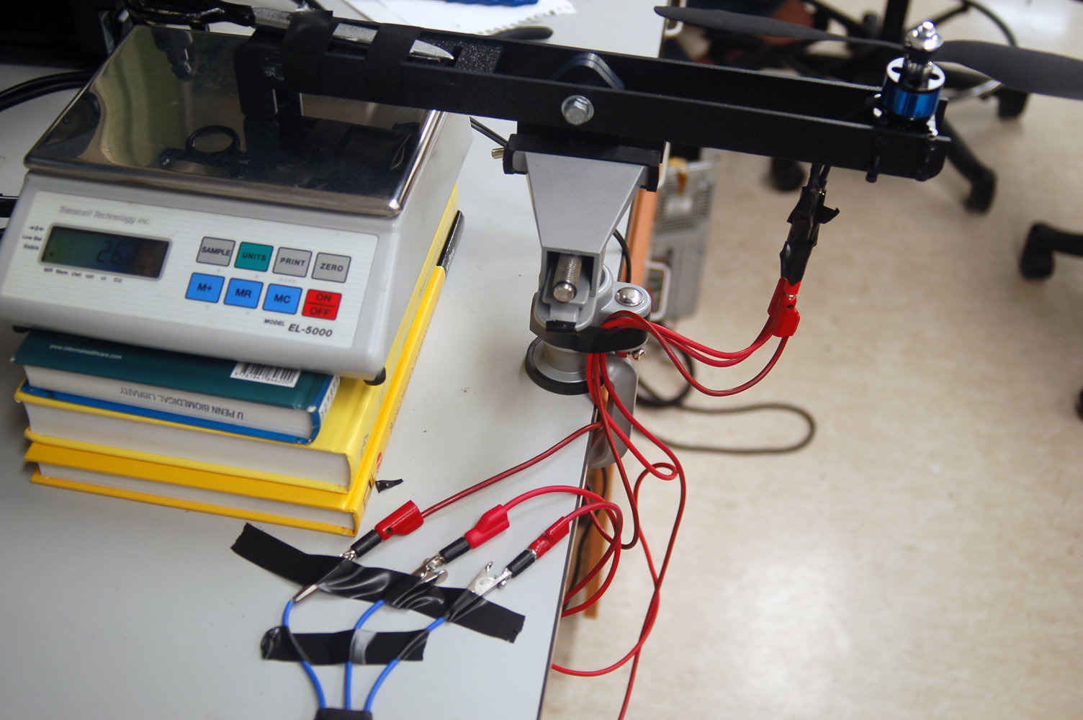
images/photos/ThrustTestOct29/thrustTest.JPG
