mlab-upenn/Remote-Autonomous-Vehicle-Explorer-Network/images/graphics/blockDiagram.pdf

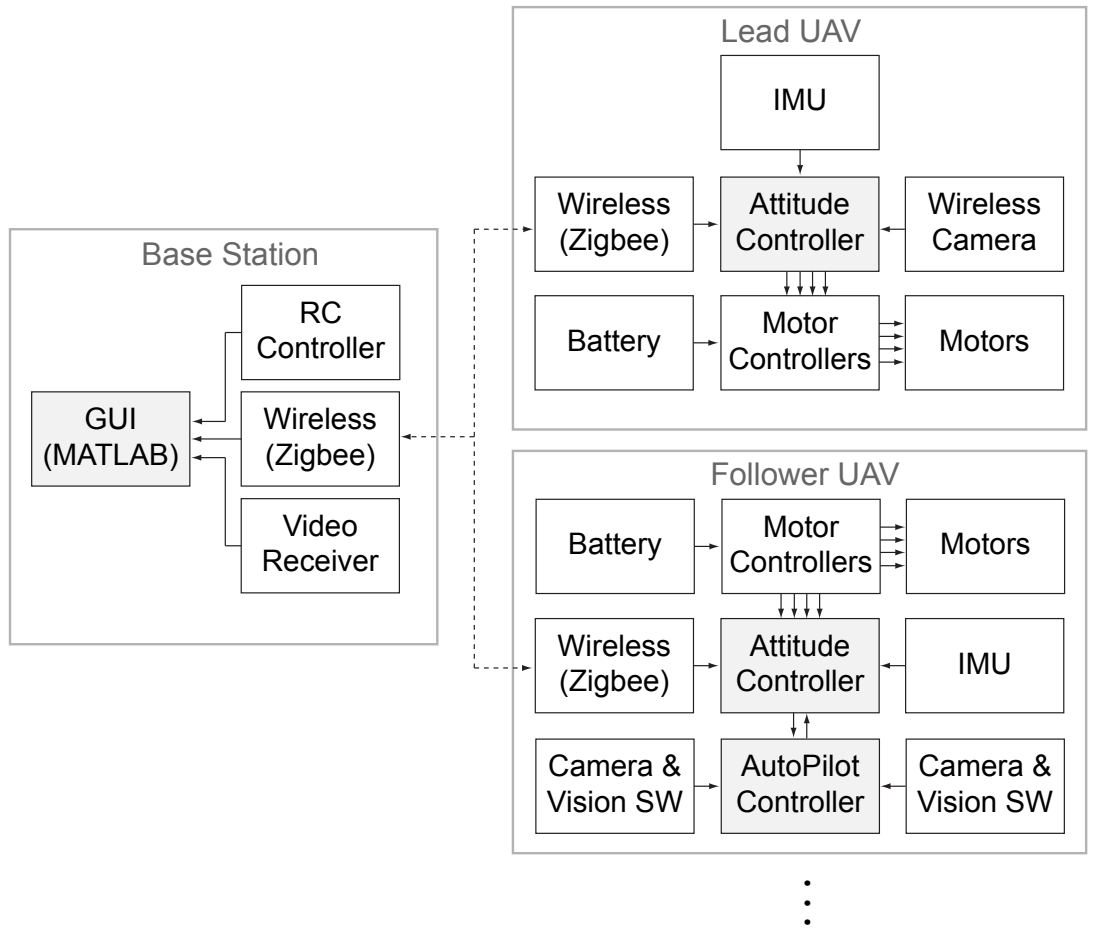
[picture p90: page 1]
Wireless (Zigbee); Base Station RC Controller; Video Receiver; GUI (MATLAB); Lead UAV; Battery; Motor; Controllers; Attitude Controller; Motors; IMU; Wireless Camera; Follower UAV; Camera & Vision SW; AutoPilot Controller
