mlab-upenn/Remote-Autonomous-Vehicle-Explorer-Network/images/graphics/modelOutline.pdf

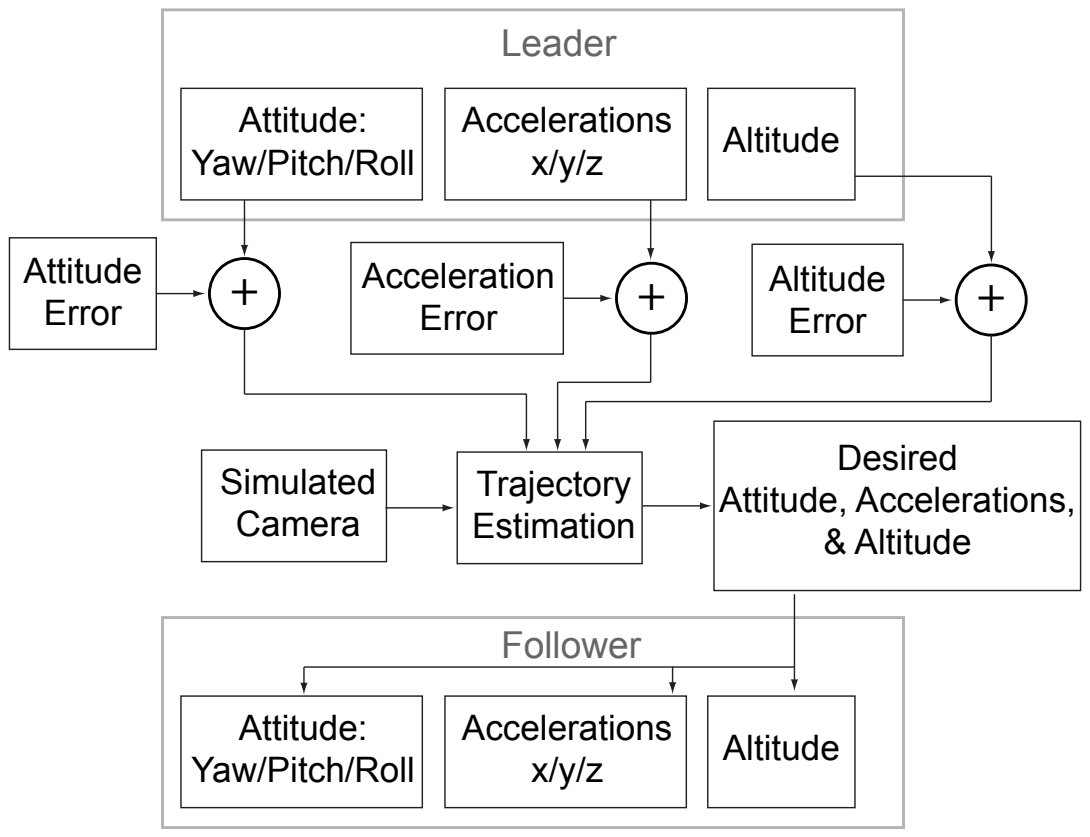
[picture p91: page 1]
Leader; Accelerations; Altitude; + Attitude; Error; + Altitude; Error + Acceleration Error; Trajectory Estimation; Simulated Camera; Follower; Desired Attitude, Accelerations, & Altitude

Attitude:
Yaw/Pitch/Roll
