mlab-upenn/Remote-Autonomous-Vehicle-Explorer-Network/images/rateGyroScreenShots/filters/filter_alpha_05.pdf

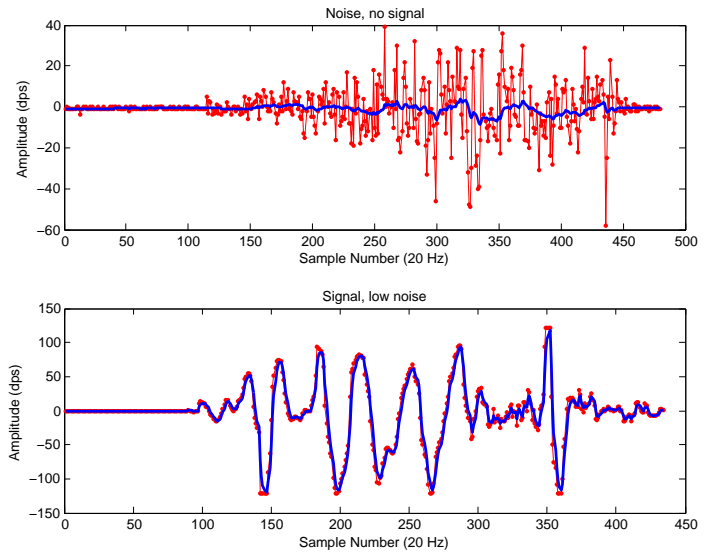
[picture p93: page 1]
Amplitude (dps)

Noise, no signal

Sample Number (20 Hz)

Signal, low noise
