mlab-upenn/Remote-Autonomous-Vehicle-Explorer-Network/codebase/ESC Firmware/HK-SS_20a_ppm/18a_tpro_schematic.pdf

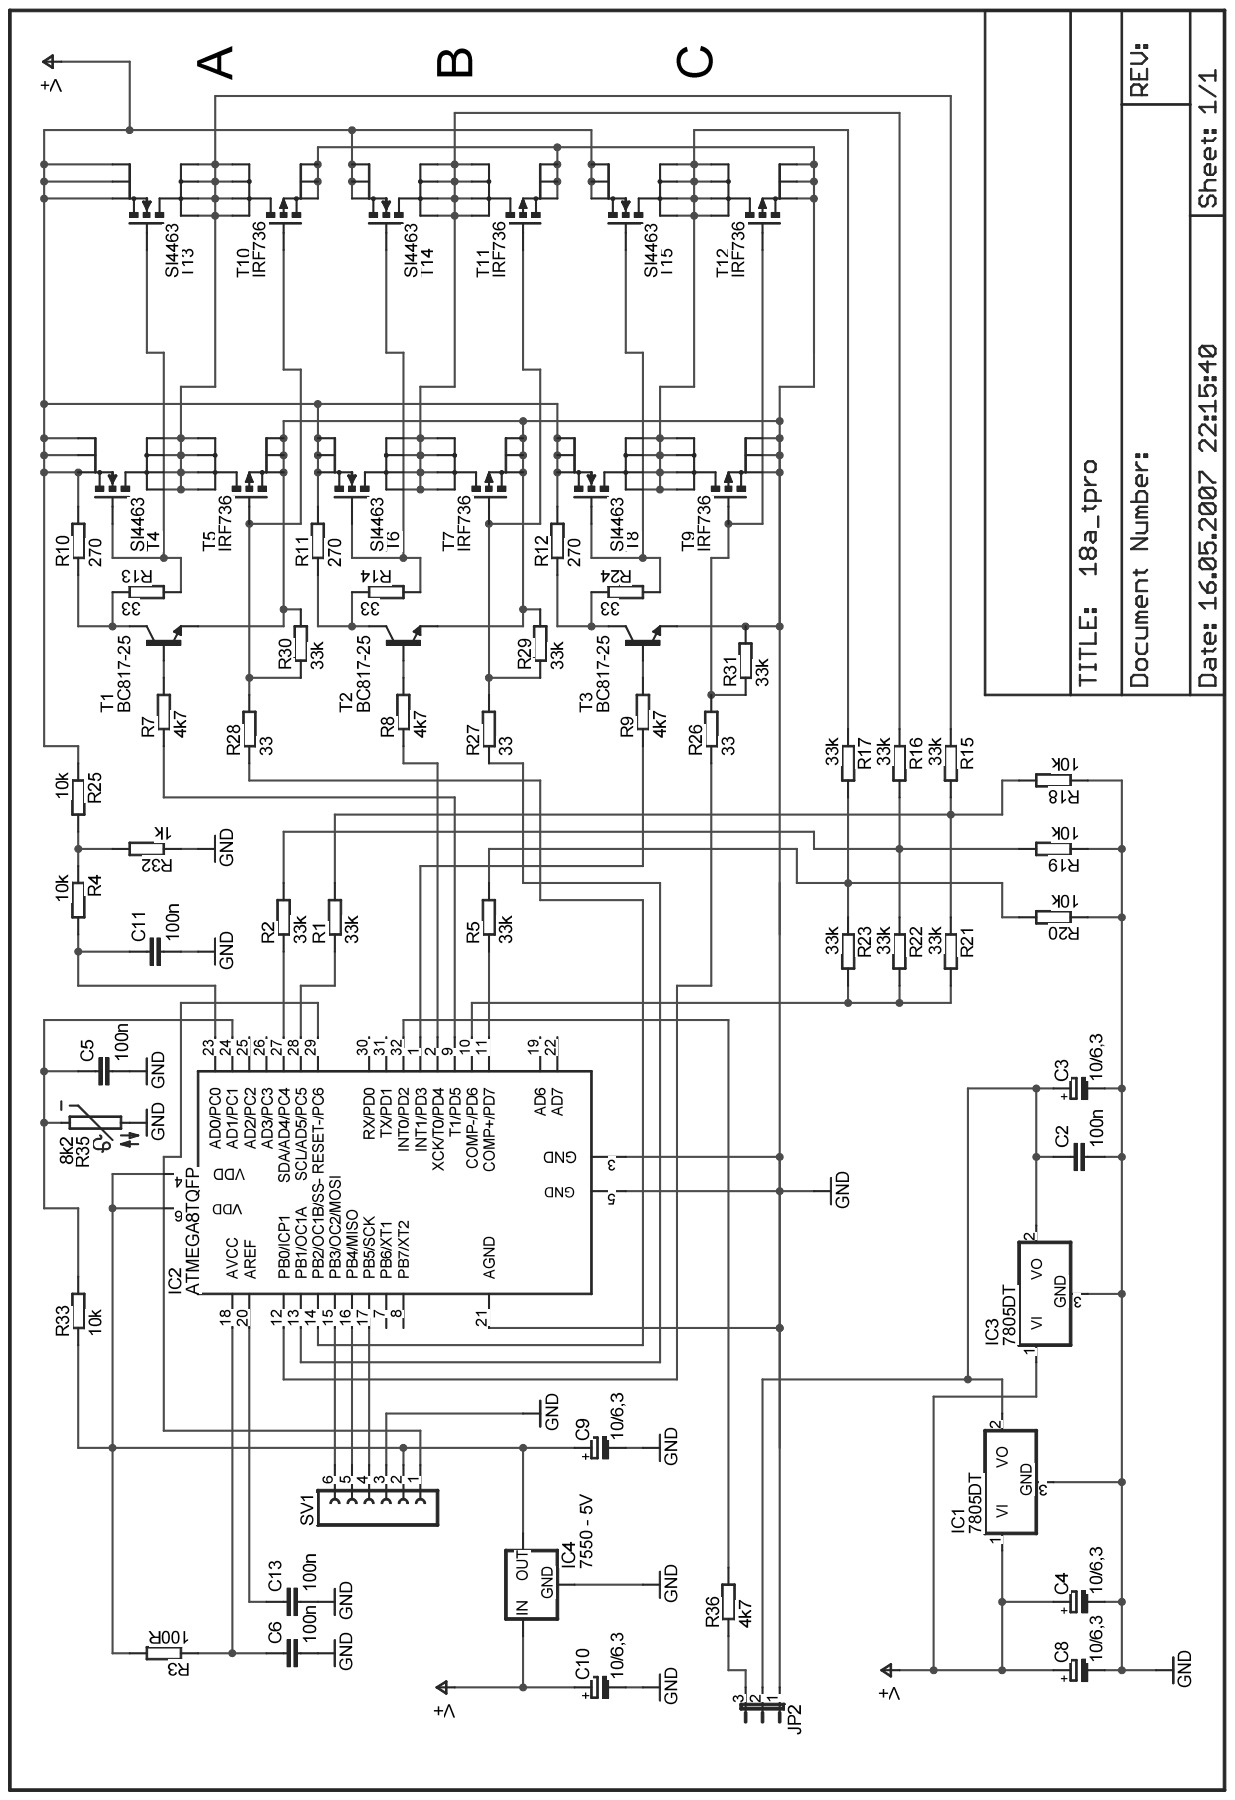
[picture p95: page 1]
