mlab-upenn/Remote-Autonomous-Vehicle-Explorer-Network/codebase/RAVEN/follower/mbed/mbedthermal.h

/********************************************************************
 R.A.V.E.N. Quadrotor - November 2010
 www.AirHacks.com
 Copyright (c) 2010.  All rights reserved.
 
 Version: 1.0
 February 12, 2011
 
 Authors:
       William Etter (UPenn EE 'll)
       Paul Martin (UPenn EE 'll)
 
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
 You should have received a copy of the GNU General Public License 
 along with this program. If not, see <http://www.gnu.org/licenses/>.
********************************************************************/

/*************************************************************************
Function Headers
**************************************************************************/
void initThermal();
void readThermal();

/*************************************************************************
Function Varibles
**************************************************************************/



/*************************************************************************
Function: initThermal()
Purpose:  Initializes the Devantech TPA81 Thermopile Array
**************************************************************************/
void initThermal(void){
    // Reset ThermalData array
    
}

/*************************************************************************
Function: readThermal()
Purpose:  Reads data from the Devantech TPA81 Thermopile Array
**************************************************************************/
void readThermal(void){
    char thermal[1];
    // Ask for Ambient Temperature Data
    thermal[0]=0x01;
    cam_i2c.write(thermal_address, thermal,1);
    // Receive Ambient Temperature Data
    cam_i2c.read(thermal_address,thermal,1);
    ThermalData.ambient = thermal[0];
    // Ask for Pixel1 Temperature Data
    thermal[0]=0x02;
    cam_i2c.write(thermal_address, thermal,1);
    // Receive Pixel1 Temperature Data
    cam_i2c.read(thermal_address, thermal,1);
    ThermalData.pixel1 = thermal[0];
    // Ask for Pixel2 Temperature Data
    thermal[0]=0x03;
    cam_i2c.write(thermal_address, thermal,1);
    // Receive Pixel2 Temperature Data
    cam_i2c.read(thermal_address,thermal,1);
    ThermalData.pixel2 = thermal[0];
    // Ask for Pixel3 Temperature Data
    thermal[0]=0x04;
    cam_i2c.write(thermal_address, thermal,1);
    // Receive Pixel3 Temperature Data
    cam_i2c.read(thermal_address, thermal,1);
    ThermalData.pixel3 = thermal[0];
    // Ask for Pixel4 Temperature Data
    thermal[0]=0x05;
    cam_i2c.write(thermal_address, thermal,1);
    // Receive Pixel4 Temperature Data
    cam_i2c.read(thermal_address, thermal,1);
    ThermalData.pixel4 = thermal[0];
    // Ask for Pixel5 Temperature Data
    thermal[0]=0x06;
    cam_i2c.write(thermal_address, thermal,1);
    // Receive Pixel5 Temperature Data
    cam_i2c.read(thermal_address,thermal,1);
    ThermalData.pixel5 = thermal[0];
    // Ask for Pixel6 Temperature Data
    thermal[0]=0x07;
    cam_i2c.write(thermal_address, thermal,1);
    // Receive Pixel6 Temperature Data
    cam_i2c.read(thermal_address, thermal,1);
    ThermalData.pixel6 = thermal[0];
    // Ask for Pixel7 Temperature Data
    thermal[0]=0x08;
    cam_i2c.write(thermal_address, thermal,1);
    // Receive Pixel7 Temperature Data
    cam_i2c.read(thermal_address, thermal,1);
    ThermalData.pixel7 = thermal[0];
    // Ask for Pixel8 Temperature Data
    thermal[0]=0x09;
    cam_i2c.write(thermal_address, thermal,1);
    // Receive Pixel8 Temperature Data
    cam_i2c.read(thermal_address, thermal,1);
    ThermalData.pixel8 = thermal[0];
}
